baobuibk/SpaceLiinTech_HighVoltage_Electroporator_HW_V3.0.0_Controller/01_DESIGN/PCB1.PcbDoc.htm

Reporting Options

# File in Previous Format

Date | : | 3/28/2026
Time | : | 12:04:26 AM
Filename | : | D:\LAB209B3\SpaceLiinTech_Eletroporator\DuAn_HighVoltage_V3_270326\DuAn_HighVoltage_V3\PCB1.PcbDoc

Version | Warning
Release 24.4 | CAUTION - This PCB document contains polygon pours with the "Obey Rules" option enabled. If you save the PCB document in this older version, the "Obey Rules" option will be turned off for these polygon pours.

This file was generated by a later version of the software
