baobuibk/SpaceLiinTech_HighVoltage_Electroporator_HW_V3.0.0_Controller/03_BOM/DuAn_HighVoltage_V3.2.xlsx

HV_Elec_Controller_V3_HW |  |  |  |  |  |  | SMT
Line # | Name | Description | Designator | Footprint | Manufacturer | Part Num | Quantity | QtyTotal | QtySent | Note
 | 10uF/25V | CAP CER 10UF 25V X5R 0603 | C1A, C1B, C3A, C3B, C5A, C5B, C7A, C7B, C25, C28, C32, C34, C50, C51, C53, C56, C58, C62, C64, C112, C114, C116, C121 | CN-SMD-0603 | Samsung Electro-Mechanics | CL10A106MA8NRNC | 23
 | 100nF/25V | CAP CER 0.1UF 25V X7R 0603 | C2A, C2B, C4A, C4B, C6A, C6B, C8A, C8B, C26, C29, C30, C33, C35, C37, C52, C54, C57, C59, C63, C65, C66A, C66B, C67, C68, C69, C70, C71, C72, C73, C74A, C74B, C75A, C75B, C76, C77, C78, C81, C82, C83, C84, C85, C86, C87, C88, C89, C90, C105, C106, C107, C108, C109, C110, C111, C113, C115, C117, C118, C120, C122, C123, C124, C125, C126, C127, C128, C129, C130, C133, C134, C140, C141, C144, C145 | CN-SMD-0603 | Samsung Electro-Mechanics | CL10B104KA8NNNC | 73
 | 33pF/16V | CAP CER 33PF 16V X7R 0603 | C9A, C9B, C11A, C11B, C12A, C12B | CN-SMD-0603 | KEMET | C0603C330K4RACTU | 6
 | 0.022uF/200V | CAP CER 0.022UF 200V NP0 1206 | C10A | CN-SMD-1206 | KEMET | C1206C223J2GACAUTO | 1
 | 0.039uF/250V | CAP CER 0.039UF 250V X7R 1206 | C10B | CN-SMD-1206 | KEMET | C1206C393JARACTU | 1
 | 1000uF/400V | CAP ALUM 1000UF 20% 400V SNAP TH | C13, C14, C15, C16, C17, C18, C19, C20, C21, C22 | CA-ALU-35x50 | TDK | B43305A9108M000 | 10 |  |  | Không thấy PN trong BOM cũ
 | 10000uF/63V | CAP ALUM 15000UF 20% 63V SNAP TH | C23, C24 | CA-ALU-35x50 | Cornell Dubilier Knowles | 159LBB063M2EH | 2 |  |  | Không thấy PN trong BOM cũ
 | 10nF/25V | CAP CER 10000PF 25V X7R 0603 | C27, C31, C55 | CN-SMD-0603 | Samsung Electro-Mechanics | CL10B103KB8NNNC | 3
 | 100uF/20V | CAP TANT 100UF 10% 20V 2917 | C36, C40, C41, C42, C43, C44, C45, C46, C47, C48, C49, C60, C131, C142, C143 | Tantalum 2917 | KYOCERA AVX | TAJD107K020RNJ | 15
 | 470uF/10V | CAP TANT 470UF 10% 10V 2917 | C61, C132 | Tantalum 2917 | KYOCERA AVX | TAJE477K010RNJ | 2
 | 12pF | CAP CER 12PF 50V C0G/NP0 0603 | C79, C80 | CN-SMD-0603 | Samsung Electro-Mechanics | CL10C120JB81PNC | 2
 | 4.7nF/16V | 4700 pF ±10% 16V Ceramic Capacitor X7R 0603 (1608 Metric) | C119 | CN-SMD-0603 | KEMET | C0603C472K4RECAUTO | 1
 | 600V/5A | DIODE STANDARD 600V 5A DO214AB | D1A, D1B, D2A, D2B | DIO-SMD-C | Vishay General Semiconductor - Diodes Division | VS-5ECU06-M3/9AT | 4
 | 1N5819W | DIODE SCHOTTKY 40V 1A SOD123FL | D3A, D3B, D5A, D5B | DIO-SMD-123 | SMC Diode Solutions | 1N5819W | 4
 | SK34A | DIODE SCHOTTKY 40V 3A DO214AC | D4, D8 | DIO-SMD-A | SMC Diode Solutions | SK34A | 2
 | 1N4148 | DIODE STANDARD 100V 150MA SOD323 | D7, D9, D10 | DIO-SMD-323 | MCC (Micro Commercial Components) | 1N4148WX-TP | 3
 | DDZ9699T | DIODE ZENER 12V 150MW SOD523 | DZ1 | DIO-SMD-523 | Diodes Incorporated | DDZ9699T-7 | 1
 | ROCKET SW | CONN HEADER R/A 2POS 3.96MM | J1 | S2P-VH(LF)(SN) | JST Sales America Inc. | S2P-VH | 1
 | Header2 | Connector 2 | J2, J3A, J3B | XH2.54-2-DIP |  |  | 3
 | Header4 | Connector 4 | J4, J8, J12, J13, J14, J16 | XH2.54-4-DIP |  |  | 6
 | SM04B-SRSS-TBLFSN | CONN HEADER SMD R/A 4POS 1MM | J5 | BM04B-SRSS-TB | JST Sales America Inc. | SM04B-SRSS-TB | 1
 | Header3 | Connector 3 | J9 | XH2.54-3-DIP |  |  | 1
 | CHAR | CONN HEADER R/A 2POS 3.96MM | J10 | S2P-VH(LF)(SN) | JST Sales America Inc. | S2P-VH | 1
 | BAT | CONN HEADER R/A 2POS 3.96MM | J11 | S2P-VH(LF)(SN) | JST Sales America Inc. | S2P-VH | 1
 | JP3x2 | CONN RCPT 6POS 0.1 GOLD PCB | JP1, JP2, JP3, JP4, JP5, JP8 | JP3-C2T | TE Connectivity AMP Connectors | 5-534206-3 | 6
 | JP5x2 | CONN RCPT 10POS 0.1 GOLD PCB | JP6 | JP5-C2T | TE Connectivity AMP Connectors | 5-534206-5 | 1
 | 22 μH | FIXED IND 22UH 2.5A 170 MOHM SMD, P/N: SRP7050TA-220M | L1, L2 | PSM6050 | Bourns Inc. | SRP7050TA-220M | 2
 | 8.2 μH | FIXED IND 8.2UH 8A 24 MOHM SMD | L5 | PSM1040 | Bourns Inc. | SRP1038A-8R2M | 1
 | LED | LED RED CLEAR 0603 SMD | LED1, LED2, LED3 | LED-0603-RED | Wurth Elektronik | 150060RS75000 | 3
 | IPD082N10N3 G | MOSFET N-CH 100V 80A DPAK | Q1A, Q1B, Q3, Q4 | TO252-123 | UMW | IPD082N10N3G | 4
 | IPD60R600CM8XTMA1 | MOSFET N-CH 600 V 7A (Tj) 64W (Tc) Surface Mount PG-TO252-3-313 | Q2A, Q2B | TO252-123 | Infineon Technologies | IPD60R600CM8XTMA1 | 2
 | AO3400 | MOSFET N-CH 30V 5.7A SOT23-3L | Q5A, Q5B, Q17 | SOT23-123 | Alpha & Omega Semiconductor Inc. | AO3400 | 3
 | MMBT2222A | TRANS NPN 40V 0.6A SOT-23 | Q6A, Q6B | SOT23-132 | Nexperia USA Inc. | MMBT2222A,215 | 2
 | AONS21303C | MOSFET P-CH 30V 180A 8DFN | Q12, Q13 | PowerPAK SO-8 Single | Alpha & Omega Semiconductor Inc. | AONS21303C | 2
 | AON7418 | MOSFET N-CH 30V 46A/50A 8DFN | Q14, Q15 | DFN3.3x3.3_8L | Alpha & Omega Semiconductor Inc. | AON7418 | 2
 | AO3401 | P-MOS 30V 4A | Q16 | SOT23-123 | Alpha & Omega Semiconductor Inc. | AO3401 | 1
 | 1k/1% | RES SMD 1K OHM 1% 1/10W 0603 | R1A, R1B, R17, R18, R31, R35A, R35B, R59 | RES-SMD-0603 | Panasonic Electronic Components | ERJ-3EKF1001V | 8
 | 3.6K/1% | RES 3.6K OHM 1% 1W 1206 | R2A | RES-SMD-1206 | Vishay Dale | RCS12063K60FKEA | 1
 | 2.1K/1% | RES 2.1K OHM 1% 2W 1206 | R2B | RES-SMD-1206 | TE Connectivity Passive Product | 3503G2B2K1FTD | 1
 | 51R/1% | RES SMD 51 OHM 1% 1/10W 0603 | R3A, R3B, R5A, R5B | RES-SMD-0603 | Panasonic Electronic Components | ERJ-3EKF51R0V | 4
 | 11R/1% | RES SMD 11 OHM 1% 3/4W 1206 | R4A, R4B, R6A, R6B | RES-SMD-1206 | Vishay Dale | CRCW120611R0FKEAHP | 4
 | 5.1k/1% | RES SMD 5.1K OHM 1% 1/10W 0603 | R7A, R7B, R9A, R9B, R62, R67, R97A, R97B, R173, R174, R175, R176, R182 | RES-SMD-0603 | Panasonic Electronic Components | ERJ-3EKF5101V | 13
 | 470R/1% | RES 470 OHM 1% 1/10W 0603 | R8A, R8B, R26A, R26B, R27A, R27B, R53, R57, R60, R65 | RES-SMD-0603 | YAGEO | RC0603FR-07470RL | 10
 | 220k/1%/0.5W | RES SMD 220K OHM 1% 1/2W 2010 | R10, R11, R12, R13, R14, R15 | RES-SMD-2010 | Bourns Inc. | CHV2010-FX-2203ELF | 6
 | 10k/1% | RES SMD 10K OHM 1% 1/10W 0603 | R16, R19, R21, R23, R24, R28A, R28B, R36, R37, R38, R39, R40, R41, R46, R47, R52, R56, R63, R68, R69, R79, R80, R81, R82, R86, R87, R88, R89, R94, R95, R96, R98, R106, R170, R172, R185, R195, R196, R197, R198, R199, R206 | RES-SMD-0603 | Panasonic Electronic Components | ERJ-3EKF1002V | 42
 | 47K/1% | RES SMD 47K OHM 1% 1/10W 0603 | R20, R22 | RES-SMD-0603 | Panasonic Electronic Components | ERJ-3EKF4702V | 2
 | 3.24K/1% | RES SMD 3.24K OHM 1% 1/10W 0603 | R25, R70 | RES-SMD-0603 | Panasonic Electronic Components | ERJ-3EKF3241V | 2
 | 22R/1% | RES SMD 22 OHM 1% 1/10W 0603 | R29, R32, R33, R34, R42, R43, R44, R45, R48, R49, R84, R85, R90, R91, R92, R93, R99, R100, R101, R102, R103, R104, R169, R171, R177, R178, R179, R180, R200, R201, R202, R203, R204, R205 | RES-SMD-0603 | Panasonic Electronic Components | ERJ-3EKF22R0V | 34
 | 25mR/1%/1.5W | RESISTOR - ISA-PLAN SHUNT, 0.025 | R30, R181, R186 | RES-SMD-1206 | Isabellenhuette USA | VMK-R025-1.0-U | 3
 | 100k/0.5% | RES SMD 100K OHM 5% 1/2W 2010 | R50, R51 | RES-SMD-2010 | Bourns Inc. | CHV2010-JW-104ELF | 2
 | 2k/1% | RES SMD 2K OHM 1% 1/10W 0603 | R54 | RES-SMD-0603 | Panasonic Electronic Components | ERJ-3EKF2001V | 1
 | 51k/1% | RES 51K OHM 1% 1/10W 0603 | R55 | RES-SMD-0603 | YAGEO | RC0603FR-0751KL | 1
 | 3.3k/1% | RES SMD 3K3 OHM 0.1% 1/10W 0603 | R58 | RES-SMD-0603 | Panasonic Electronic Components | ERJ-3EKF3301V | 1
 | 4.7k/1% | RES SMD 4.7K OHM 1% 1/10W 0603 | R61, R66 | RES-SMD-0603 | Panasonic Electronic Components | ERJ-3EKF4701V | 2
 | 953R/1% | RES SMD 953 OHM 1% 1/10W 0603 | R64 | RES-SMD-0603 | Panasonic Electronic Components | ERJ-3EKF9530V | 1
 | 50R/50W | TPAN0263F50R0K9 | R71, R72, R73, R74, R75, R76, R77, R78 | TO263-123 |  | TPAN0263F50R0K9 | 8
 | 3k/1% | RES SMD 3K OHM 0.1% 1/10W 0603 | R83, R189, R191 | RES-SMD-0603 | Panasonic Electronic Components | ERA-3AEB302V | 3
 | 110k/1% | RES 110K OHM 1% 1/10W 0603 | R183, R187, R190 | RES-SMD-0603 | YAGEO | RC0603FR-07110KL | 3
 | 6.04k/1% | RES 6.04K OHM 1% 1/10W 0603 | R188 | RES-SMD-0603 | YAGEO | RC0603FR-076K04L | 1
 | 26.7k/1% | RES 26.7K OHM 1% 1/10W 0603 | R194 | RES-SMD-0603 | Stackpole Electronics Inc | RMCF0603FT26K7 | 1
 | DA2034_AL | Audio Transformers / Signal Transformers DA2032 Cap Chrgr For Linear LT3750/51 | Tran1A, Tran1B | DA2034_AL |  | DA2034_ALD | 2
 | UCC21551BDWKR | 4A/6A 5KVRMS DUAL-CHANNEL ISOLAT | U1A, U1B | UCC21551BDWKR | Texas Instruments | UCC21551BDWKR | 2
 | LTC4359 | IC OR CTRLR N+1 8MSOP | U2 | VSSOP8 | Analog Devices Inc. | LTC4359CMS8#TRPBF | 1
 | TPS5430DDAR | IC REG BUCK ADJ 3A 8SOPWR | U3, U6 | HSOP8 | Texas Instruments | TPS5430DDAR | 2
 | MB85RS2MTAPNF-G-BDERE1 | IC FRAM 2MBIT SPI 40MHZ 8SOP | U4 | SOIC127P602X173-8N | RAMXEED | MB85RS2MTAPNF-G-BDERE1 | 1
 | TEL 5-1212 | DC DC CONVERTER 12V 6W | U5 | TEL_5-XXYY_SINGLE | Traco Power | TEL 5-1212 | 1
 | LM1117-3.3V | IC REG LIN 3.3V 800MA SOT-223-4 | U7 | SOT223 | Texas Instruments | TLV1117-33IDCYR | 1
 | OPTO | OPTOISO 3.75KV 1CH TRANS 4-SSOP | U8A, U8B | EL3H7 | Everlight Electronics Co Ltd | EL3H7(B)(TA)-VG | 2
 | ADUM1201 | DGTL ISOLTR 2.5KV 2CH GP 8-SOIC | U9, U25 | SO8 | Analog Devices Inc. | ADUM1201CRZ-RL7 | 2
 | MAX232DR | IC TRANSCEIVER FULL 2/2 16SOIC | U10 | SO16 | Texas Instruments | MAX232DR | 1
 | TC1047AVNBTR | SENSOR ANALOG -40C-125C SOT23-3 | U11A, U11B | SOT23-132 | Microchip Technology | TC1047AVNBTR | 2
 | H3LIS331DL | ACCEL 100-400G I2C/SPI 16TFLGA | U12 | TFLGA-16L | STMicroelectronics | H3LIS331DLTR | 1
 | STM32F405RGT7 | High-performance foundation line, ARM Cortex-M4 core with DSP and FPU, 1 Mbyte Flash, 168 MHz CPU, ART Accelerator | U13 | LQFP64 | STMicroelectronics | STM32F405RGT7 | 1
 | OPA340NA/250 | IC OPAMP GP 1 CIRCUIT SOT23-5 | U14, U15 | SOT23-5 | Texas Instruments | OPA340NA/250 | 2
 | TLV7031DCKT | IC COMPARATOR 1 GEN PUR SC70-5 | U16, U17 | SOT353 | 296-49506-6-ND | TLV7031DCKT | 2
 | XBEE S3B PRO |  | U20 | XBEE S3B PRO DIP |  |  | 1
 | ADUM1250 | DGTL ISOLTR 2.5KV 2CH I2C 8-SOIC | U21 | SO8 | Analog Devices Inc. | ADUM1250ARZ-RL7 | 1
 | LTC4012IUF#PBF | IC BAT CHG MULT-CHEM 1-4CL 20QFN | U22 | PQFN50P400X400X80_HS-21N | Analog Devices Inc. | LTC4012IUF#PBF | 1
 | ADS1115 | IC ADC 16BIT SIGMA-DELTA 10X2QFN | U23 | R-PQFP-N10 | Texas Instruments | ADS1115IRUGR | 1
 | LSM6DSOX | INEMO INERTIAL MODULE: 3D ACCELE | U26 | LSM6DSOX | STMicroelectronics | LSM6DSOXTR | 1
 | XTAL_8MHz | CRYSTAL 8.0000MHZ 8PF SMD | X1 | XT4-16.000MHz-4_V | ECS Inc. | ECS-80-8-33Q-ADS | 1
 |  | Connector, module cắm ngoài
 |  | Không có stock digi
