baobuibk/SpaceLiinTech_HighVoltage_Electroporator_HW_V3.0.0_Controller/02_Sche_PDF/DuAn_HVC_PDF.pdf

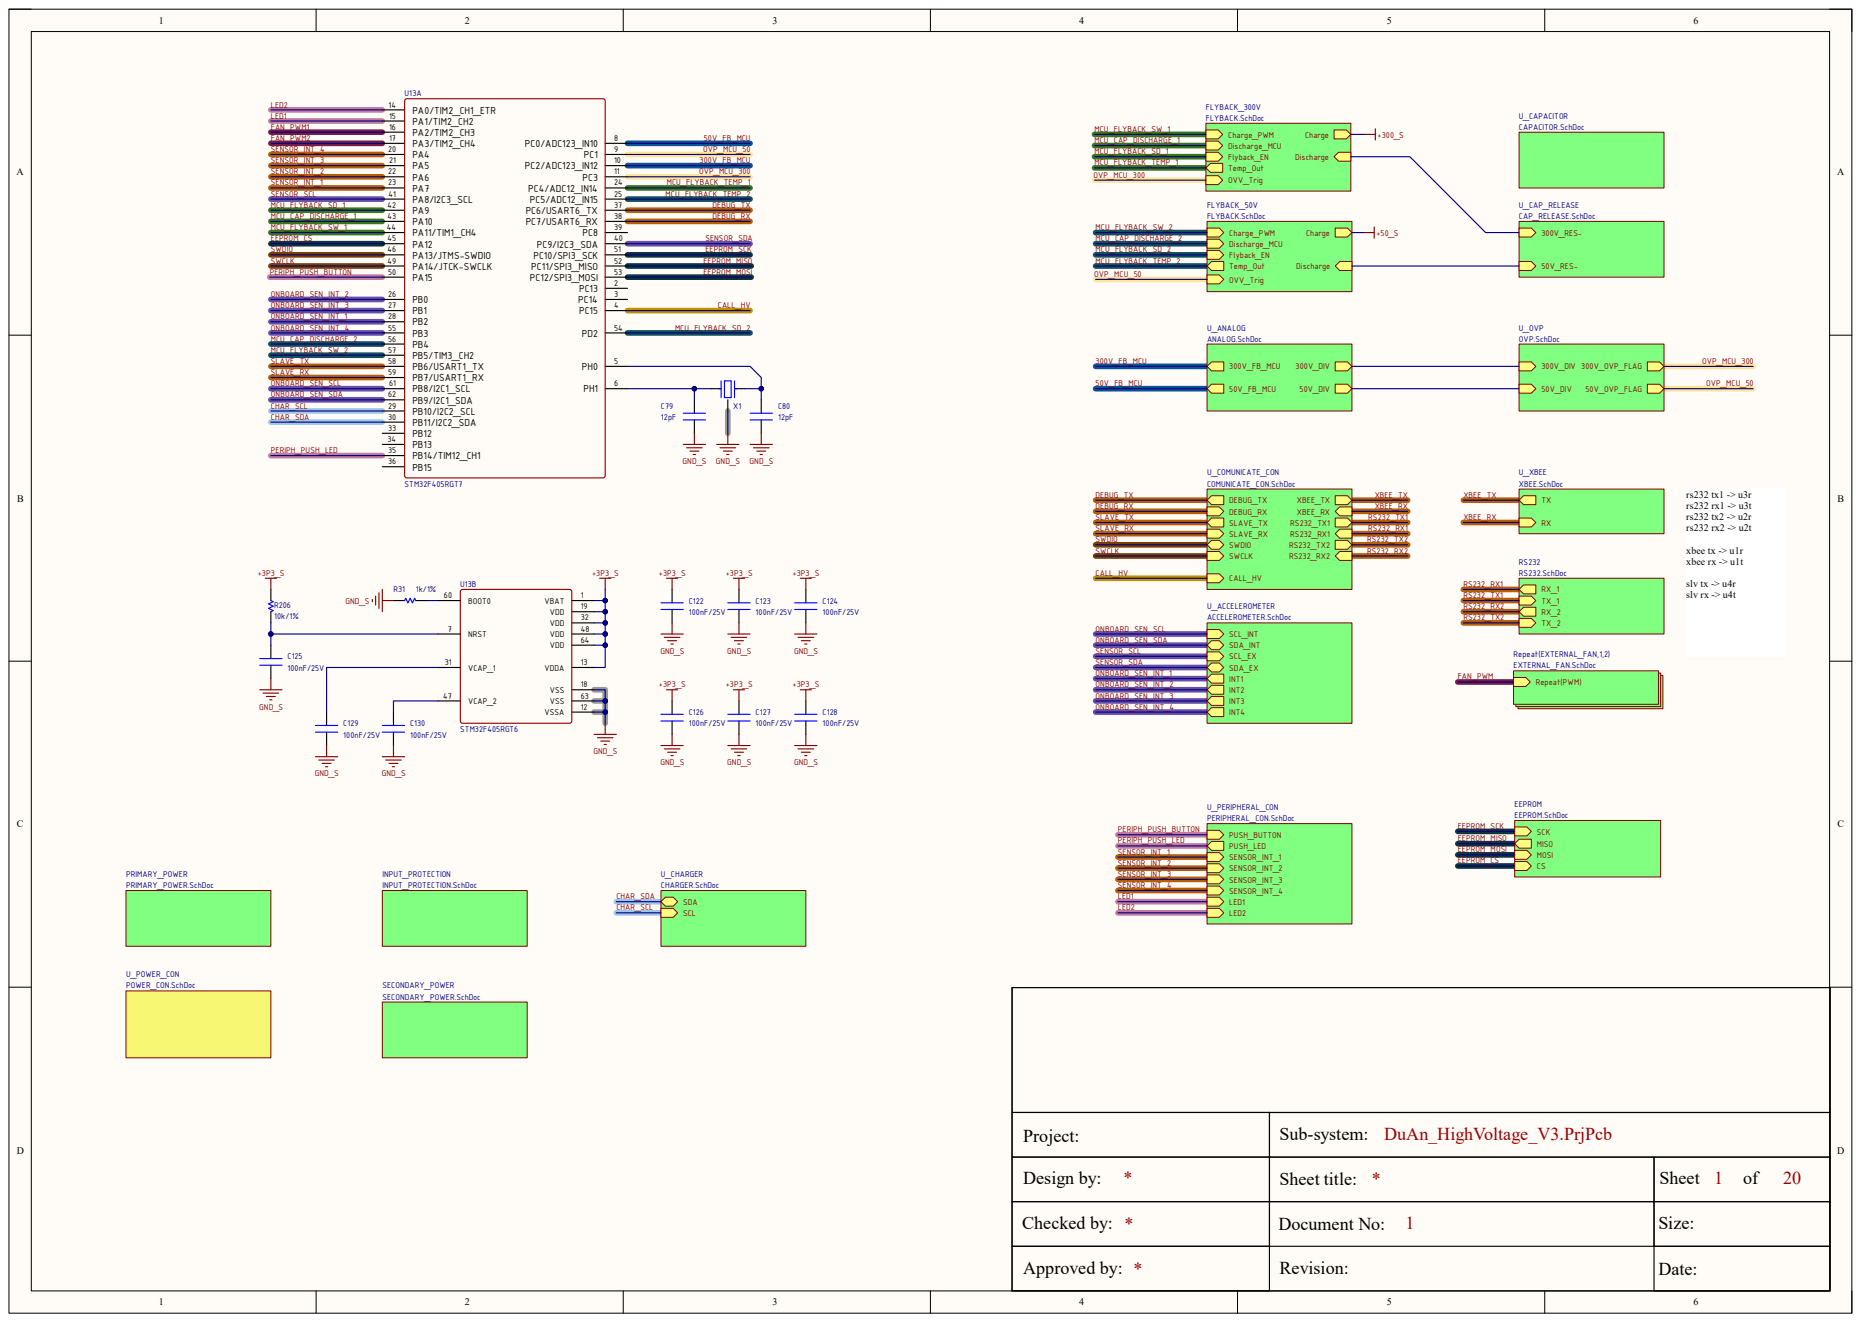
[picture p4: page 1]

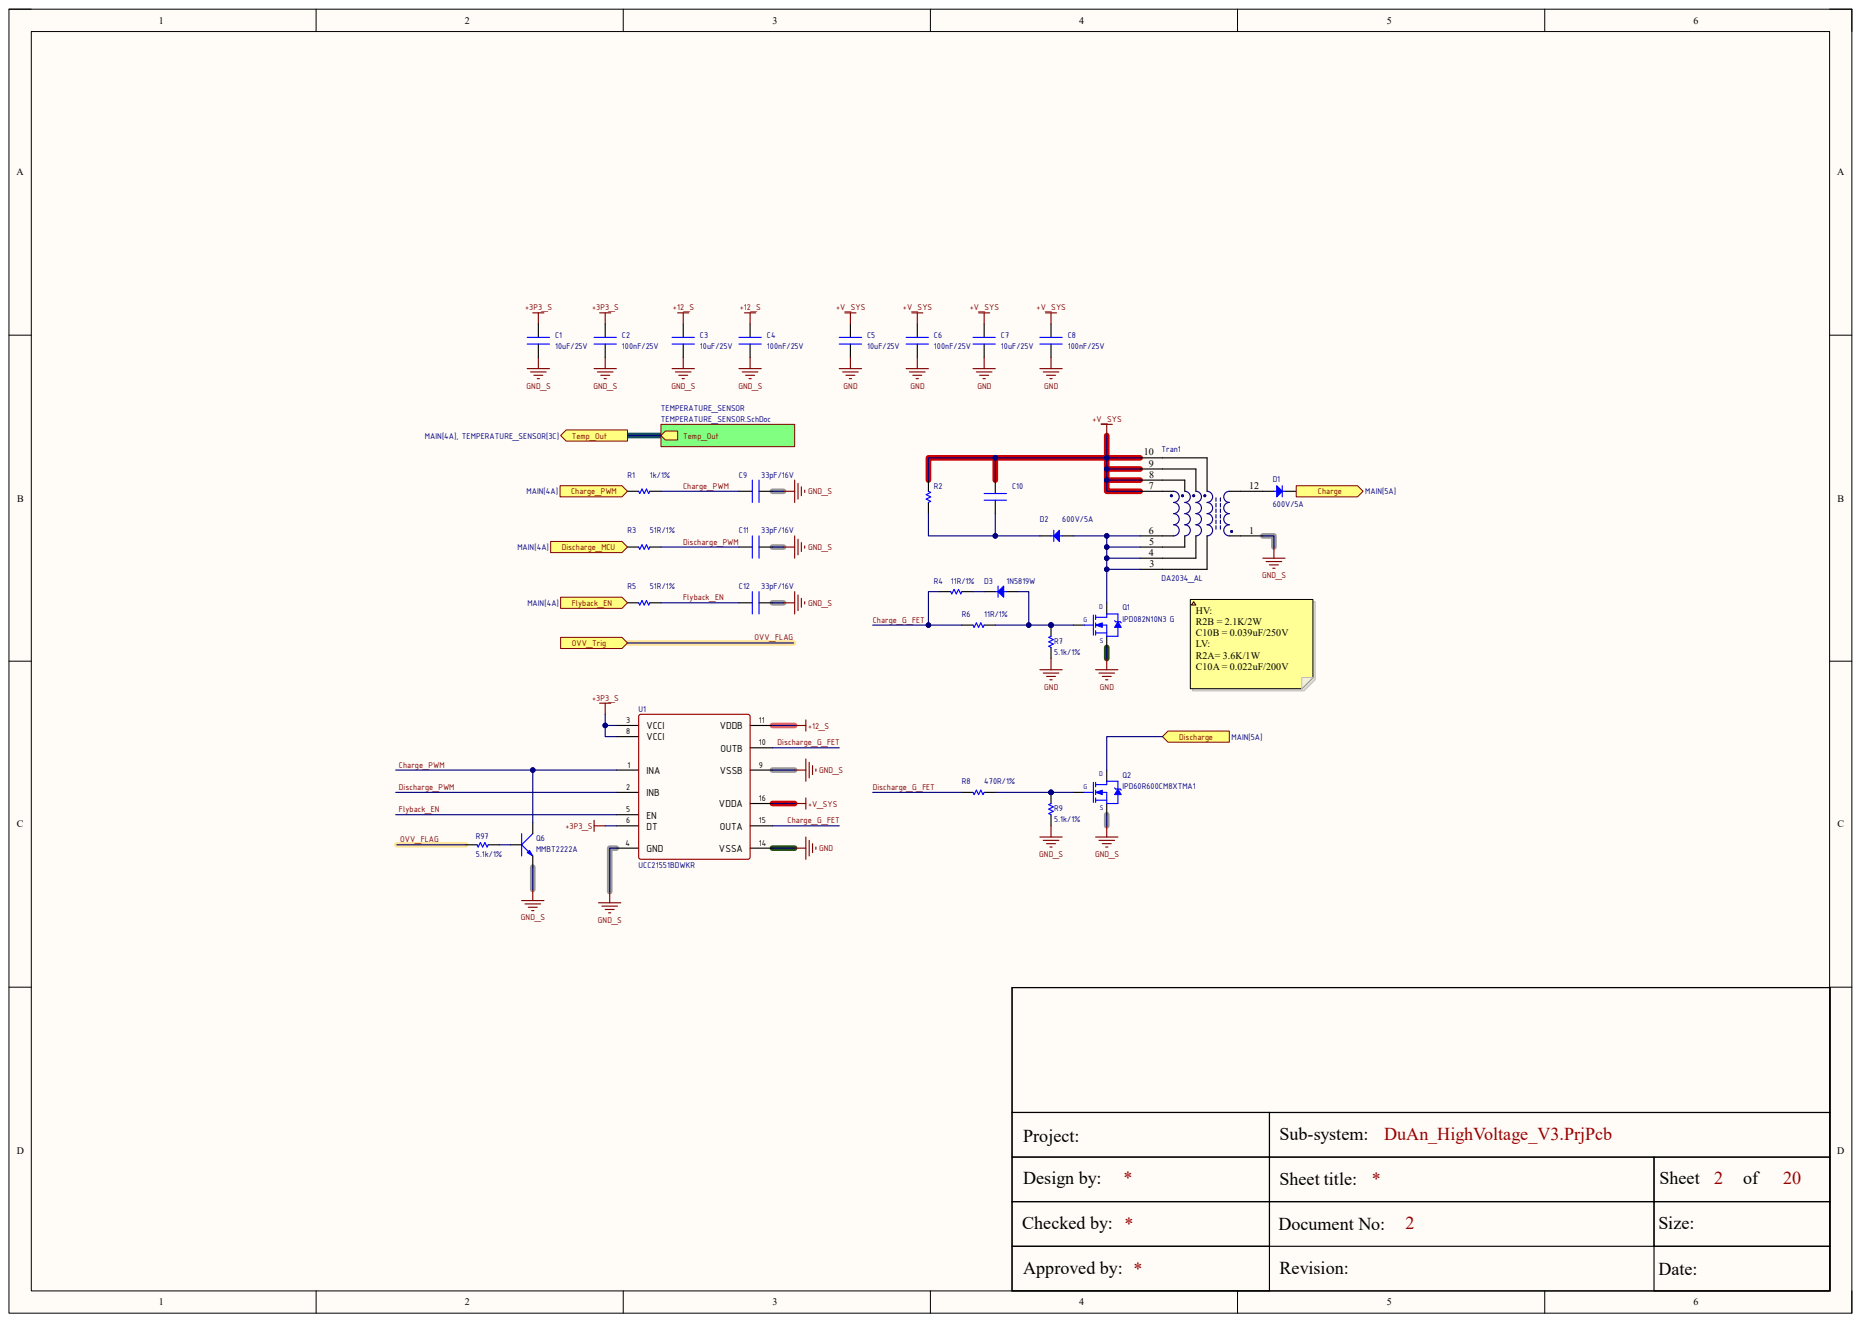
[picture p5: page 2]

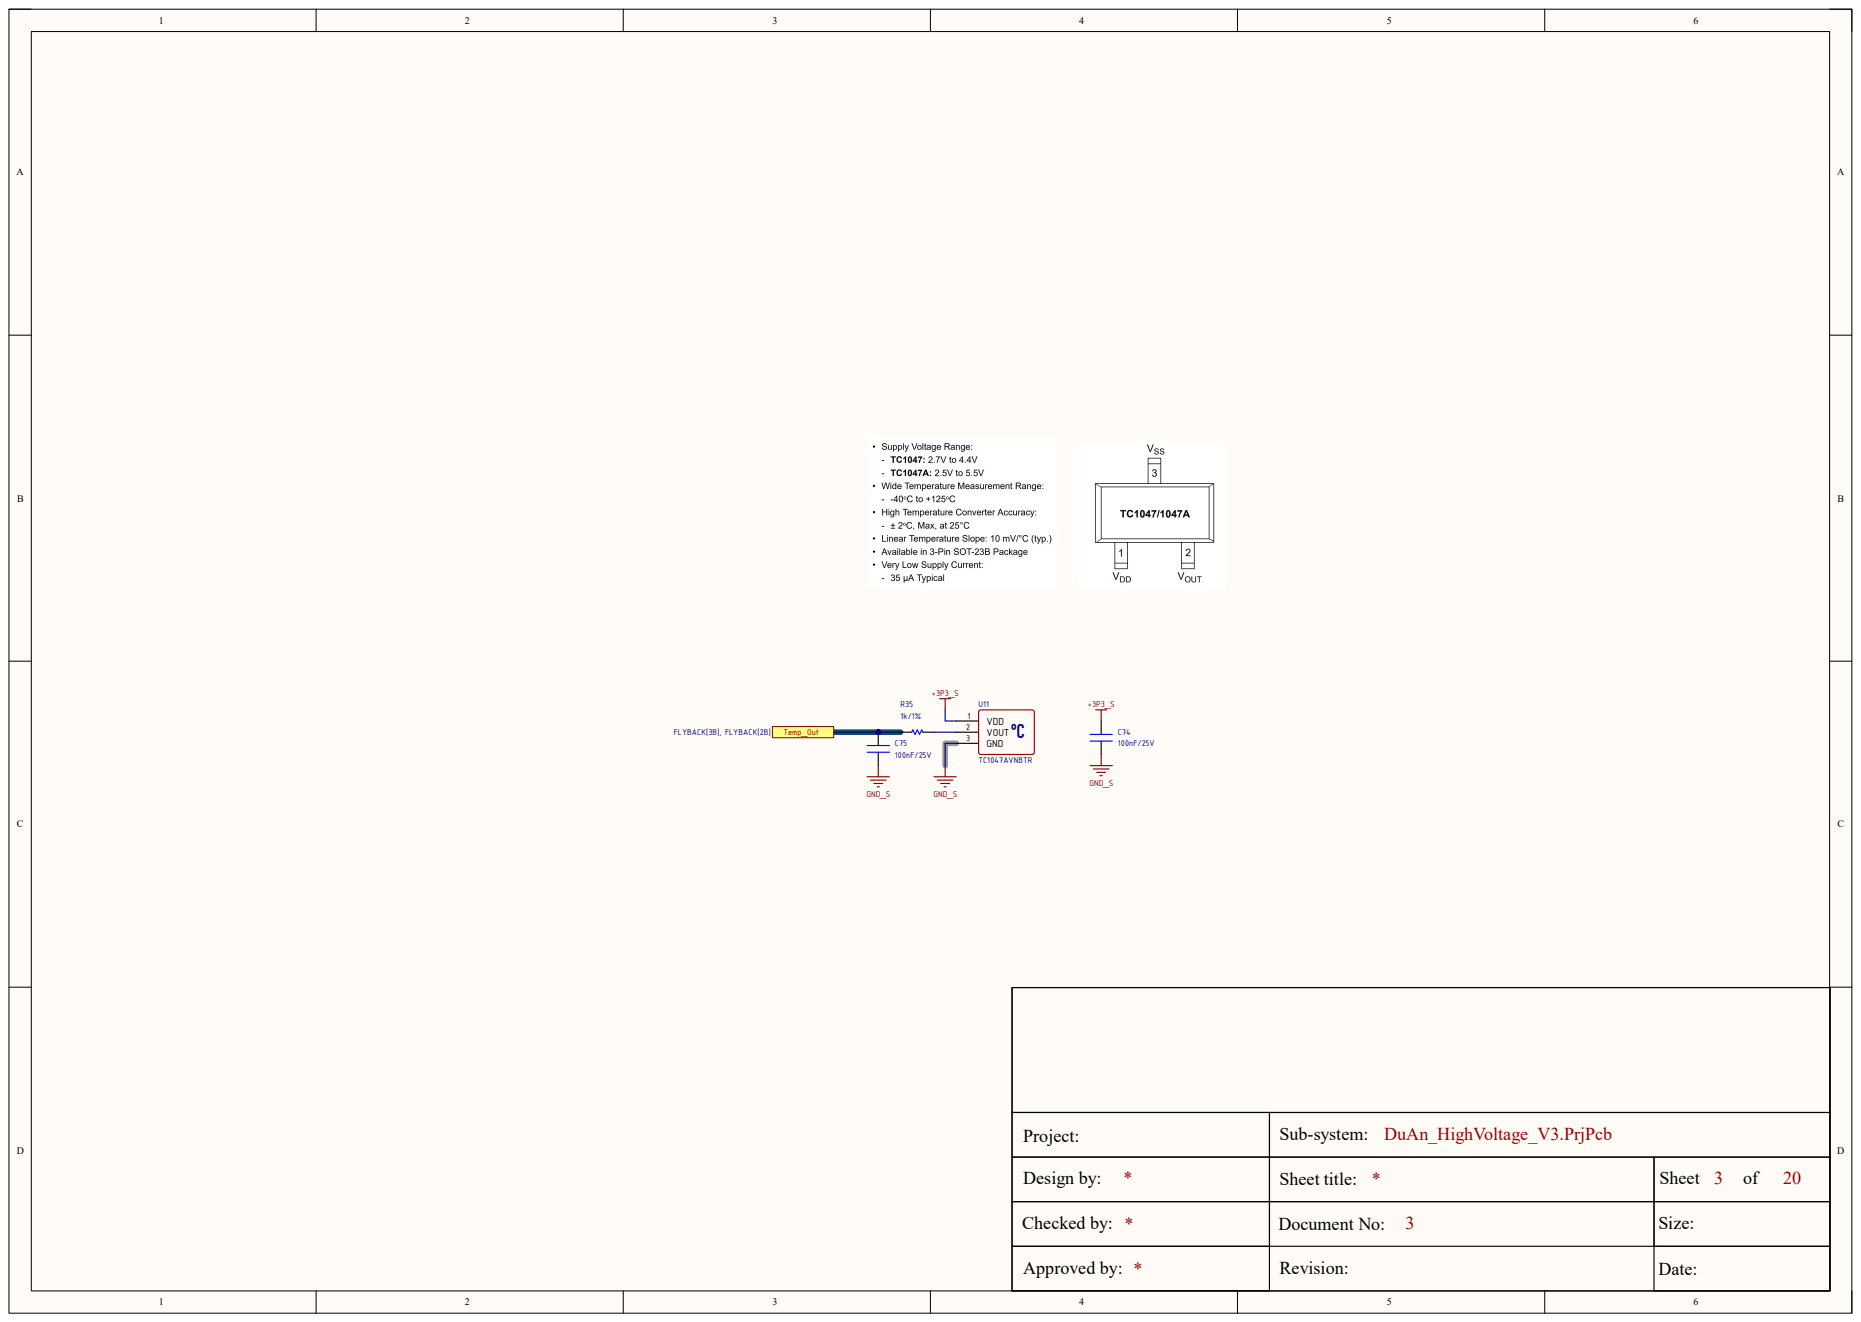
[picture p6: page 3]
Project:; Design by:; Sub-system:; Sheet title:; Sheet; DuAn_HighVoltage_V3.PrjPcb; VDD ¹ VOUT ²; GND ³; TC1047AVNBTR; GND_S; FLYBACK[3B], FLYBACK[2B] Temp_Out

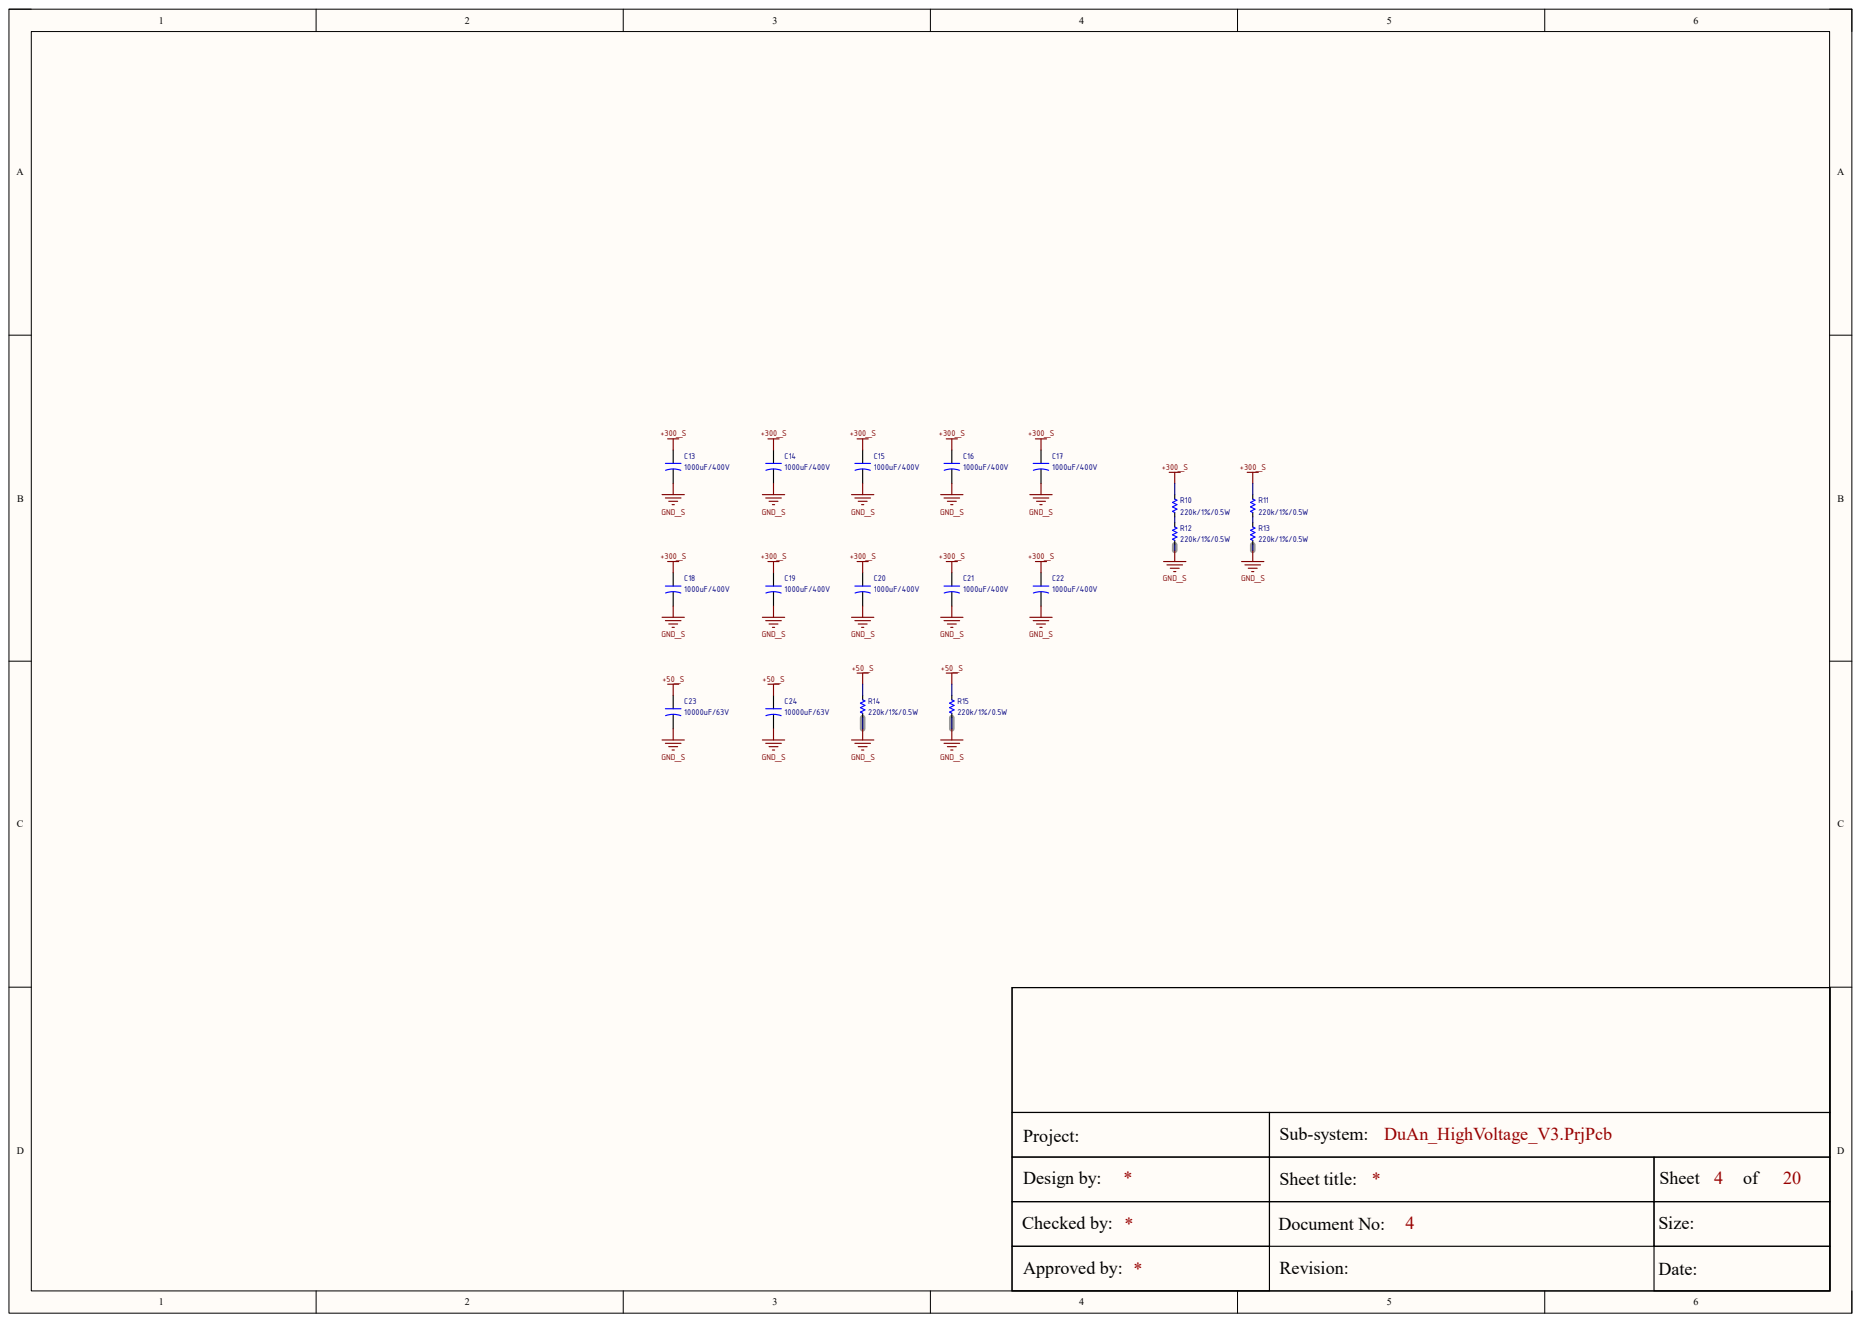
[picture p7: page 4]

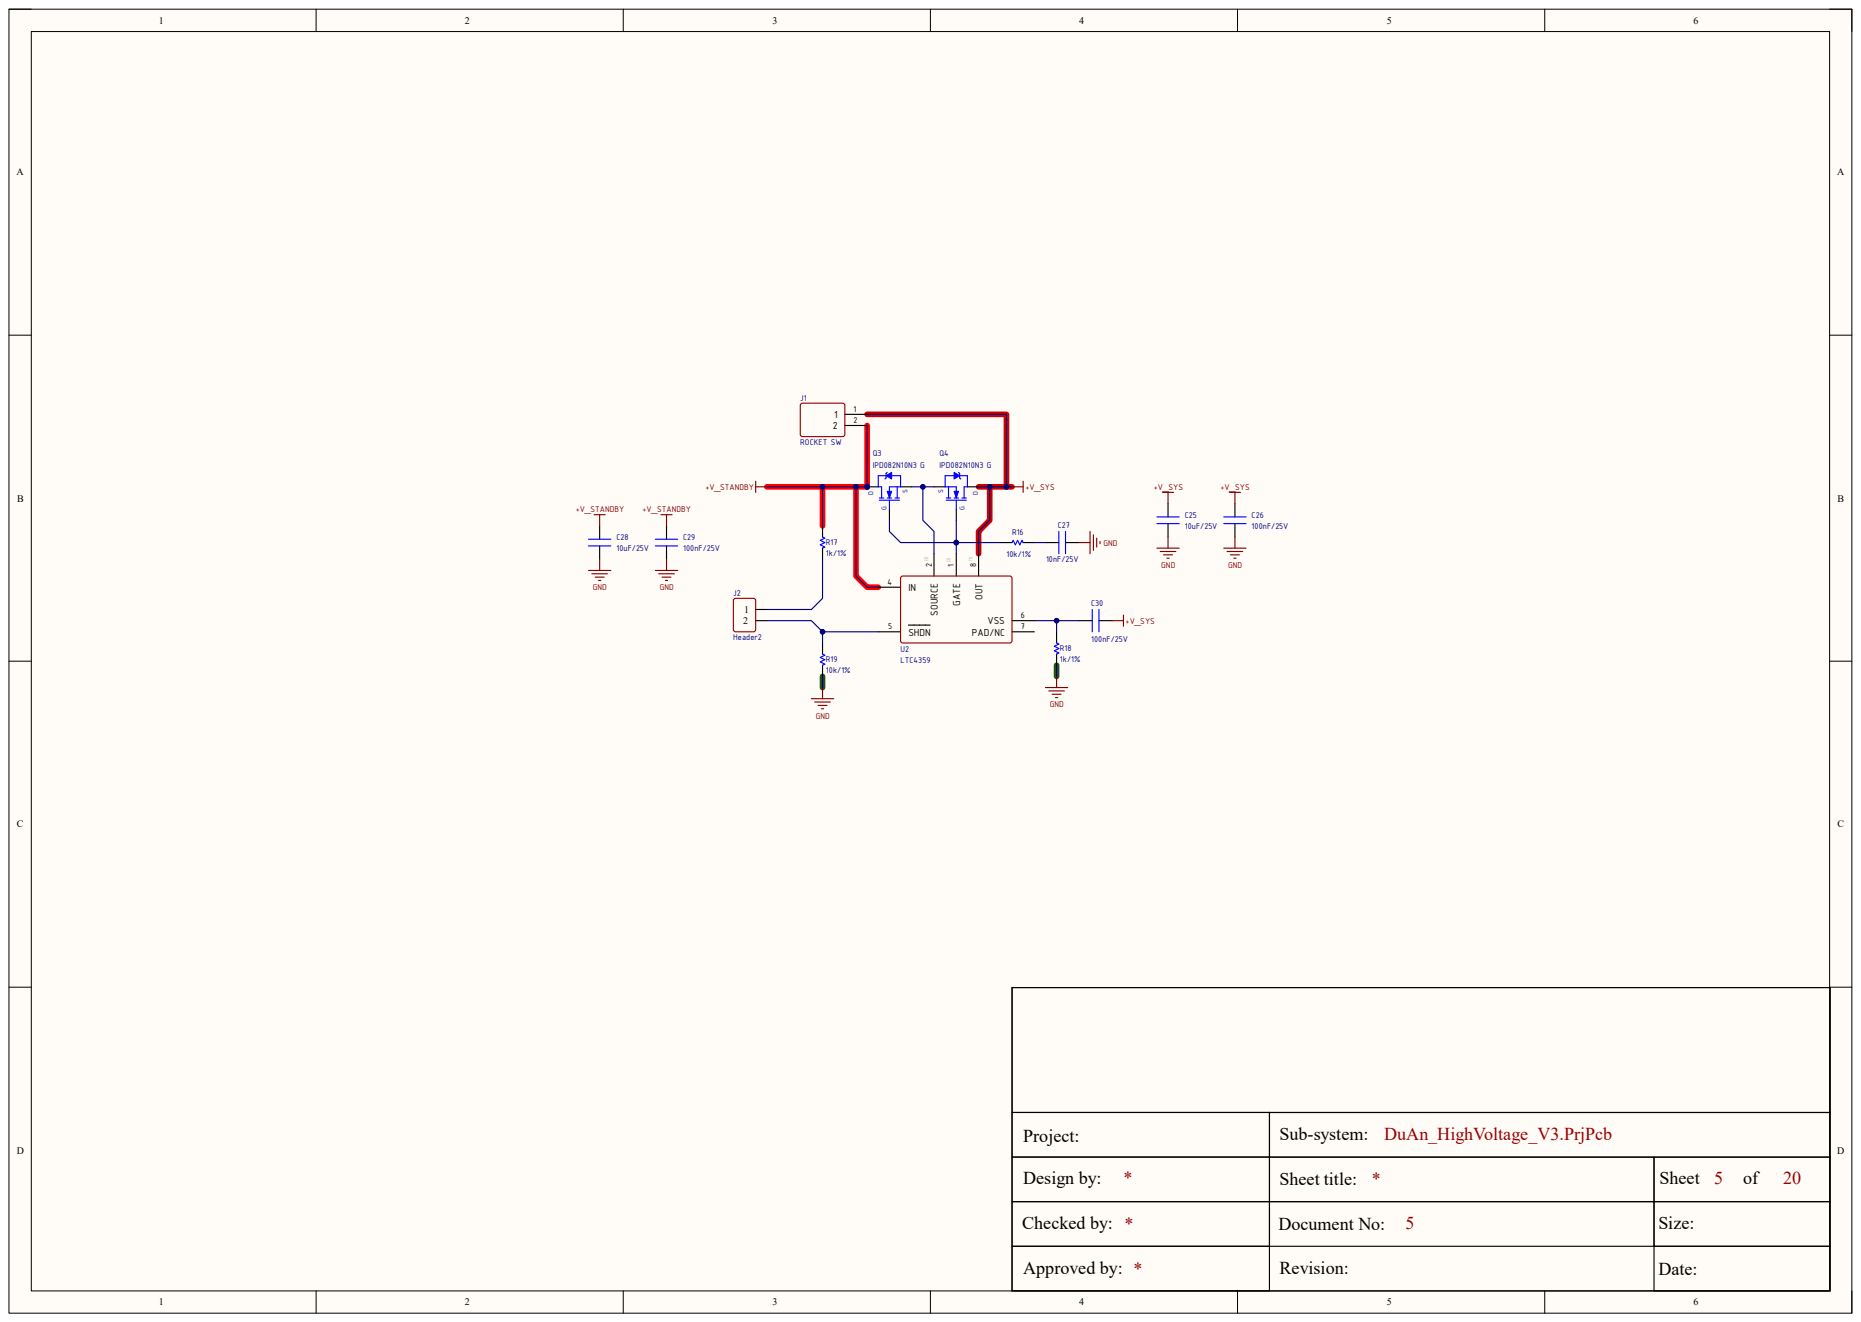
[picture p8: page 5]

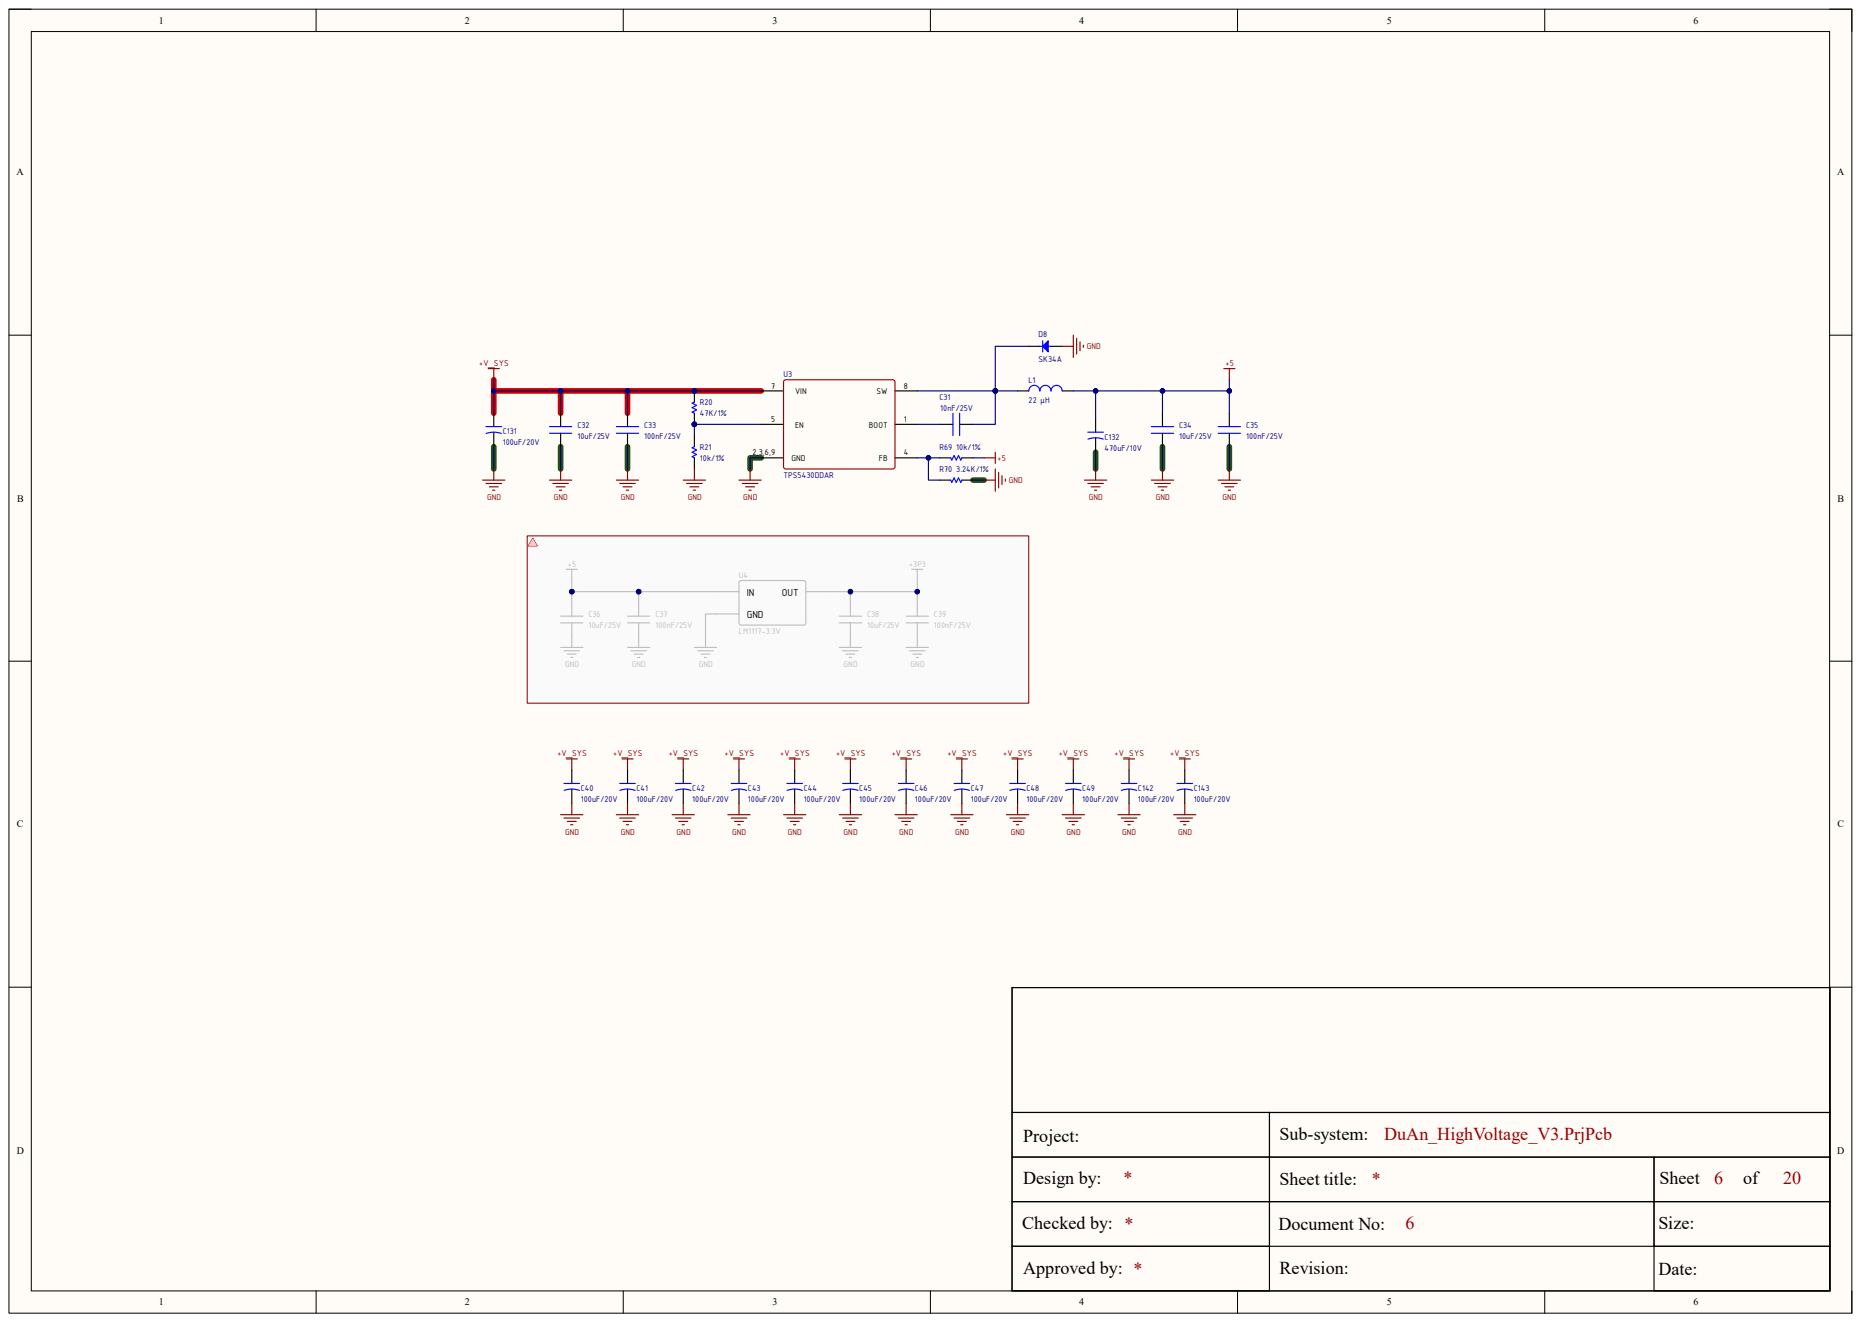
[picture p9: page 6]

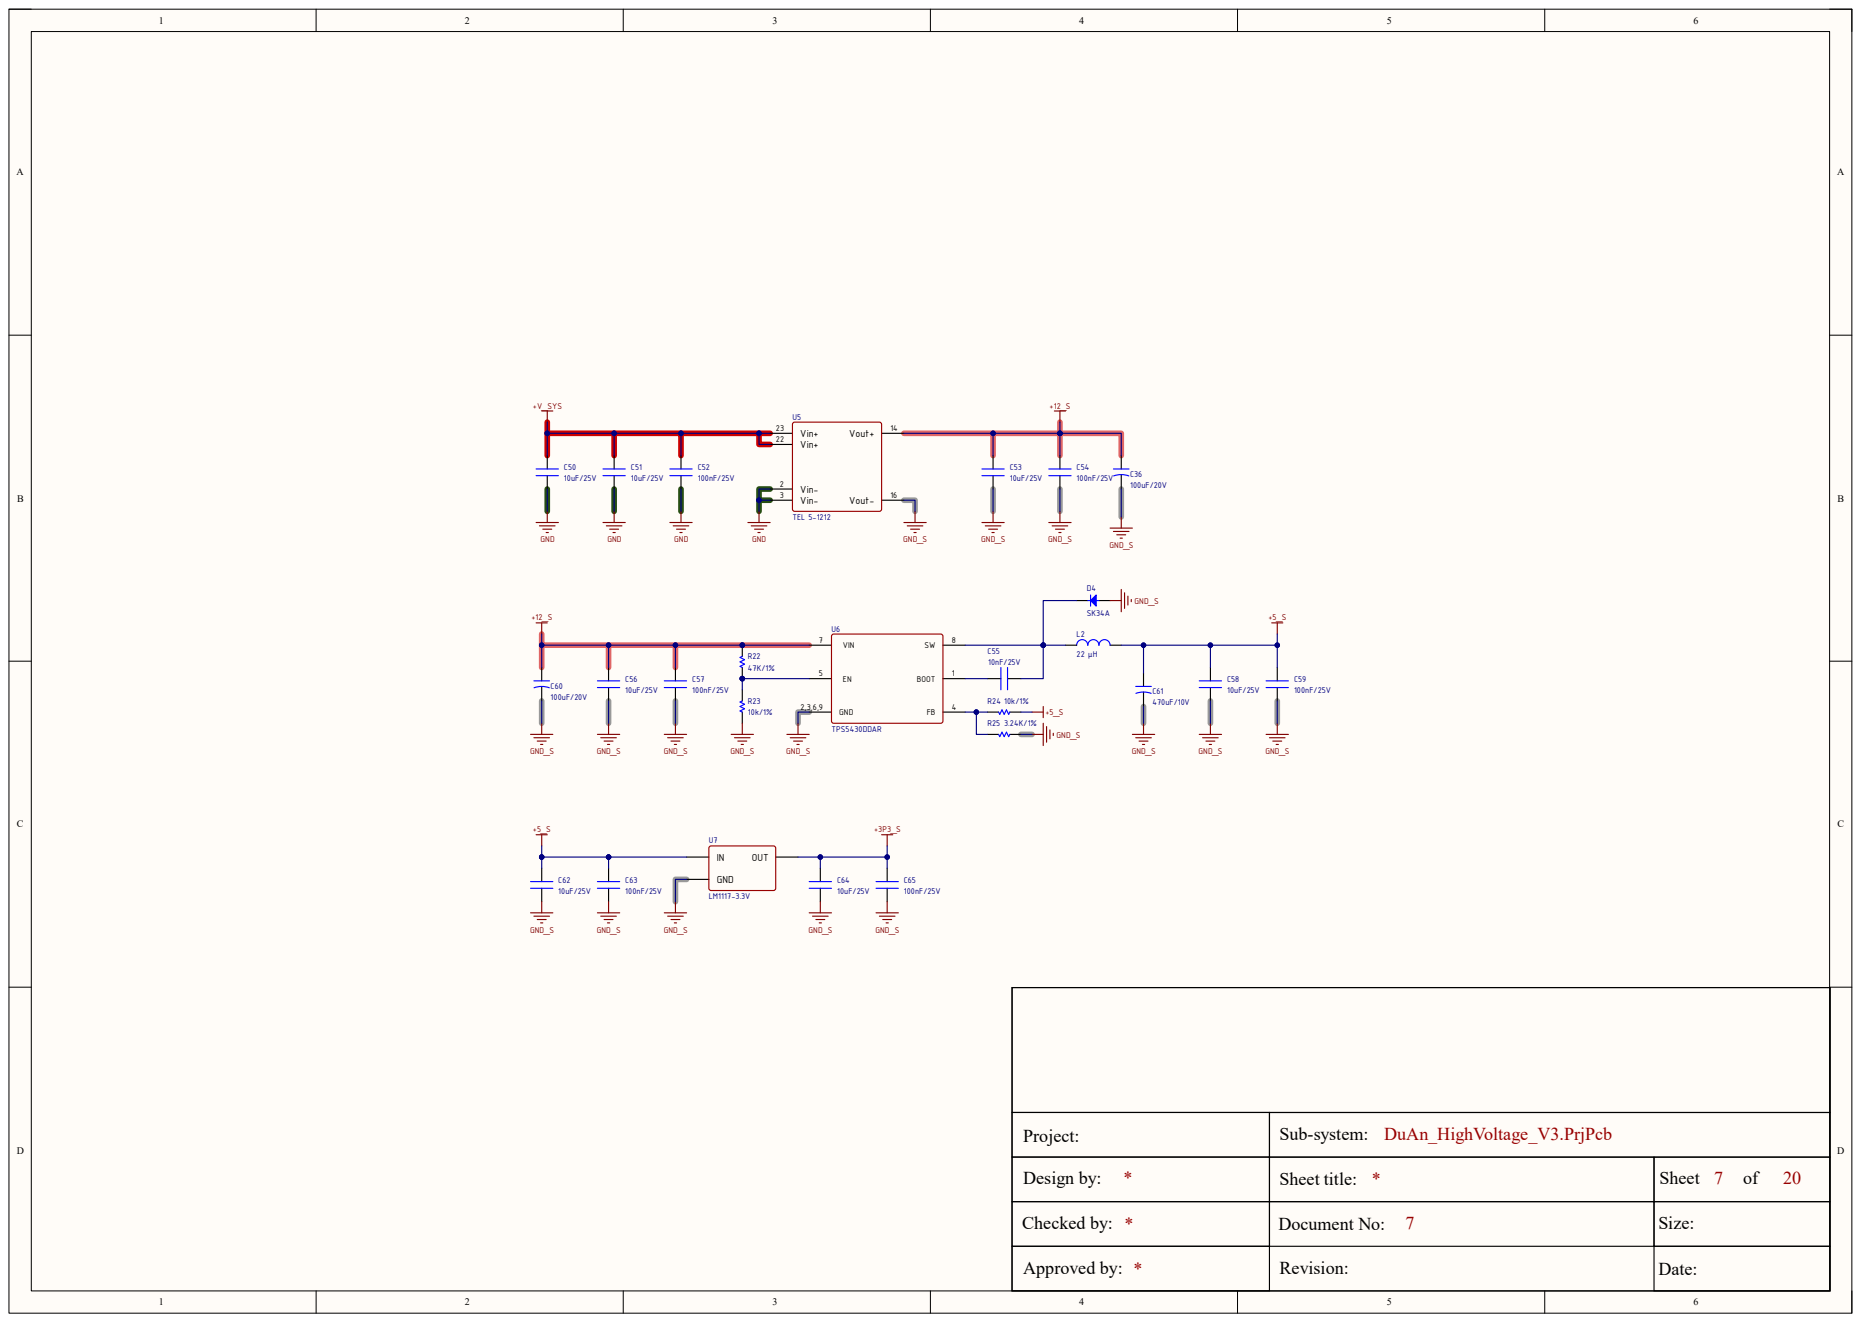
[picture p10: page 7]

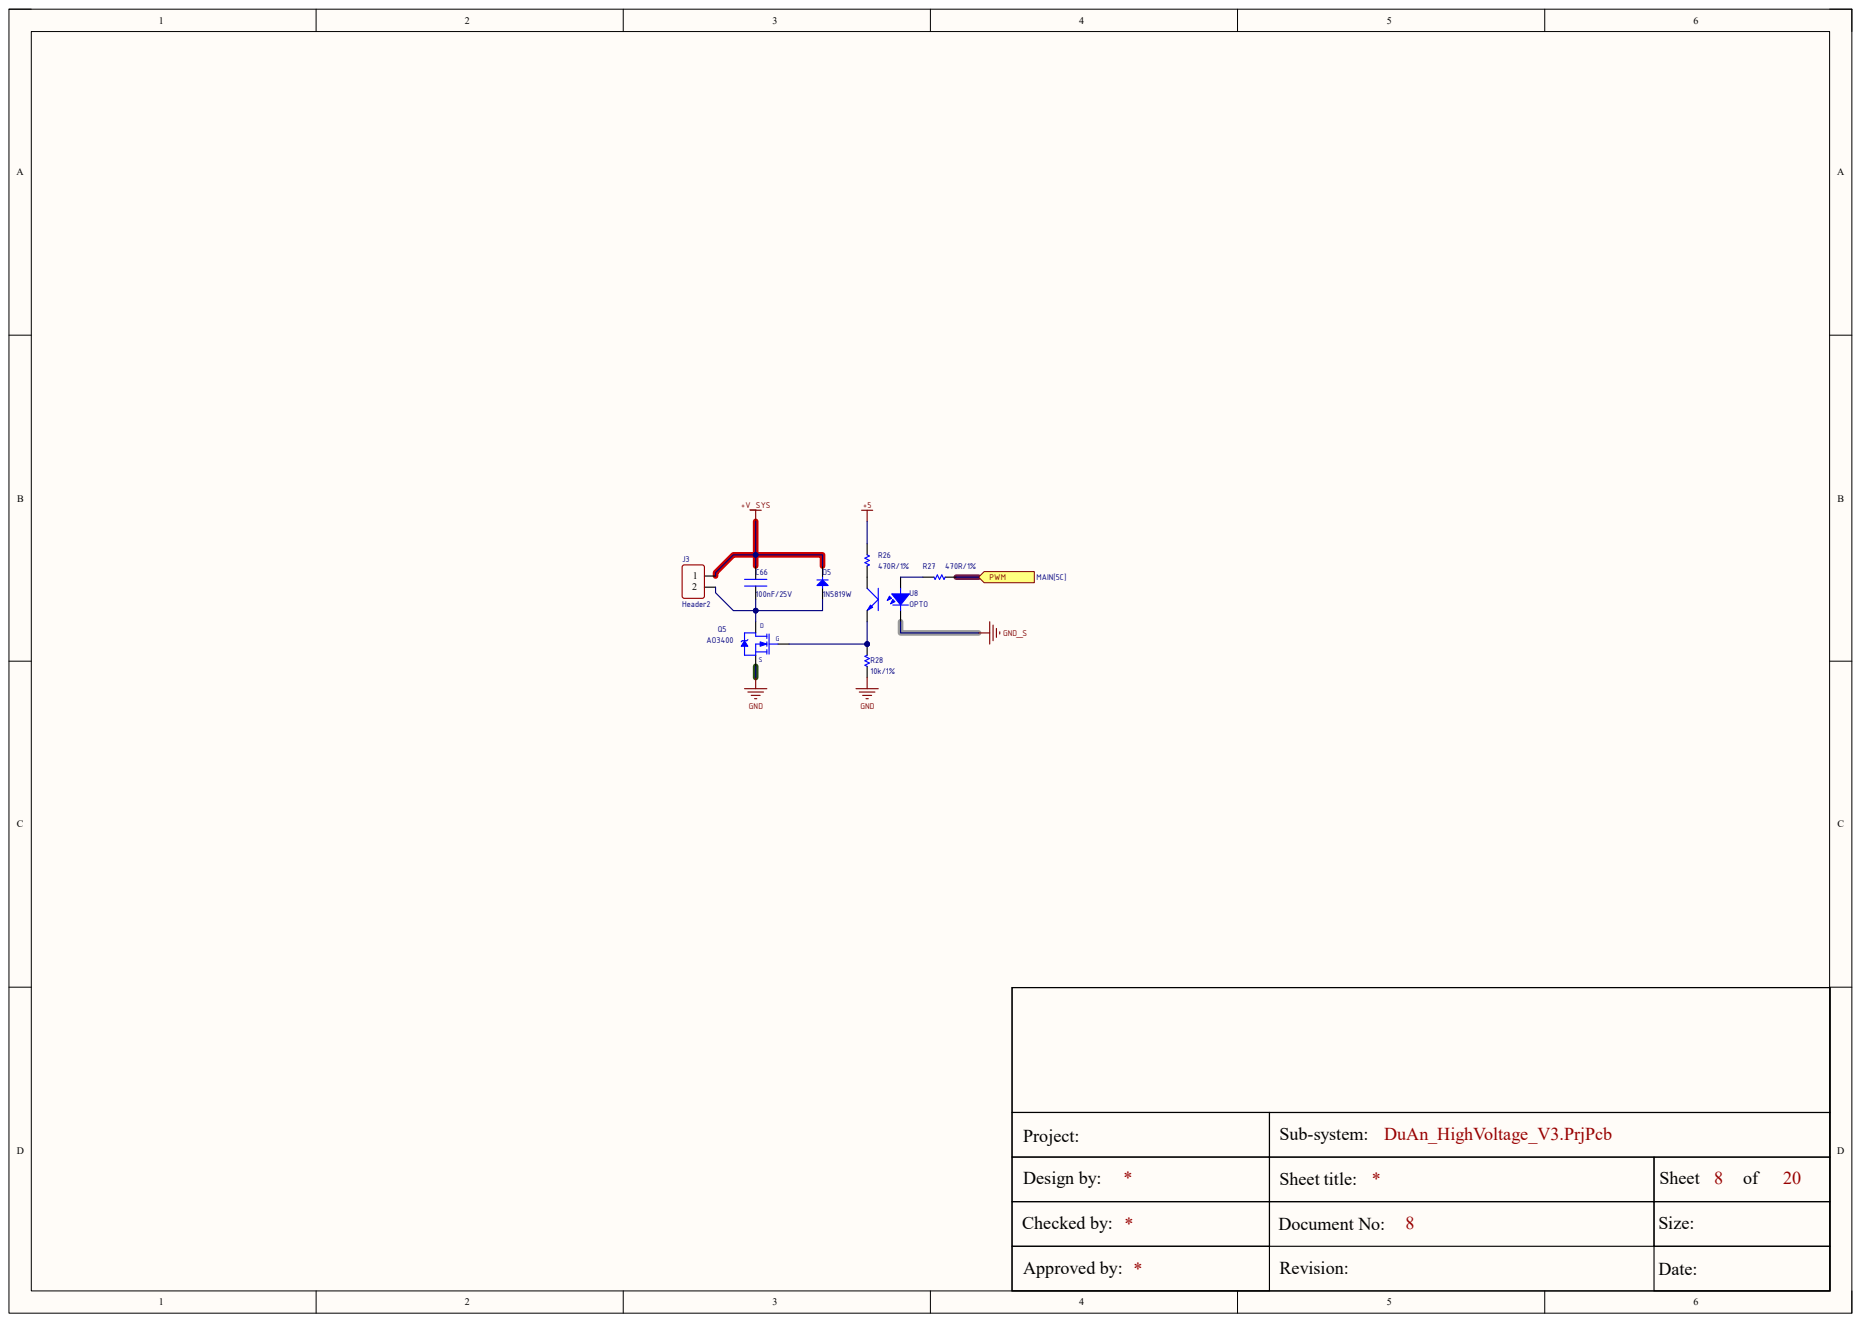
[picture p11: page 8]

## VDD.1 ¹

## VDD.2 8

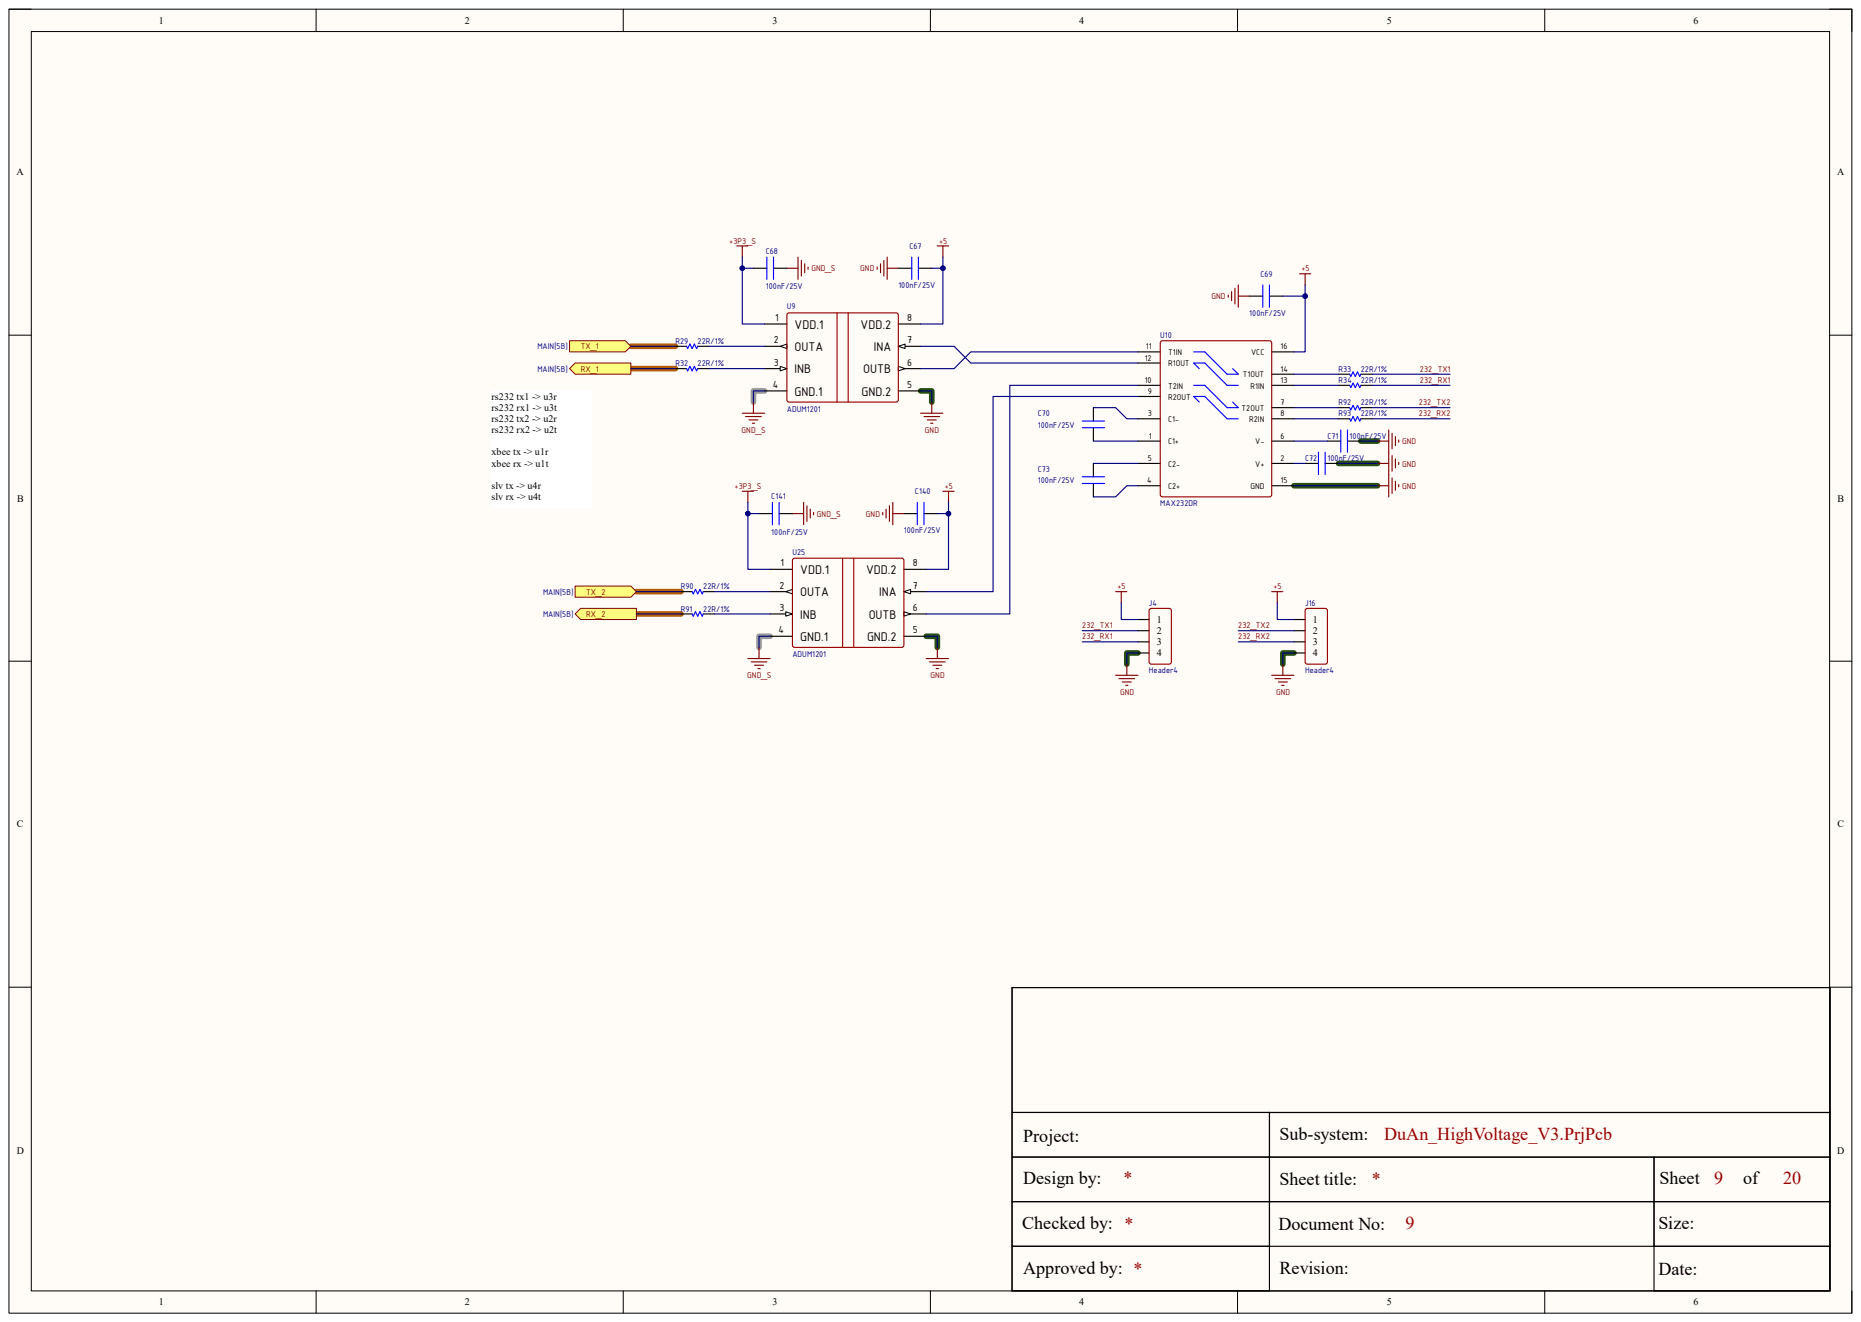
[picture p12: page 9]

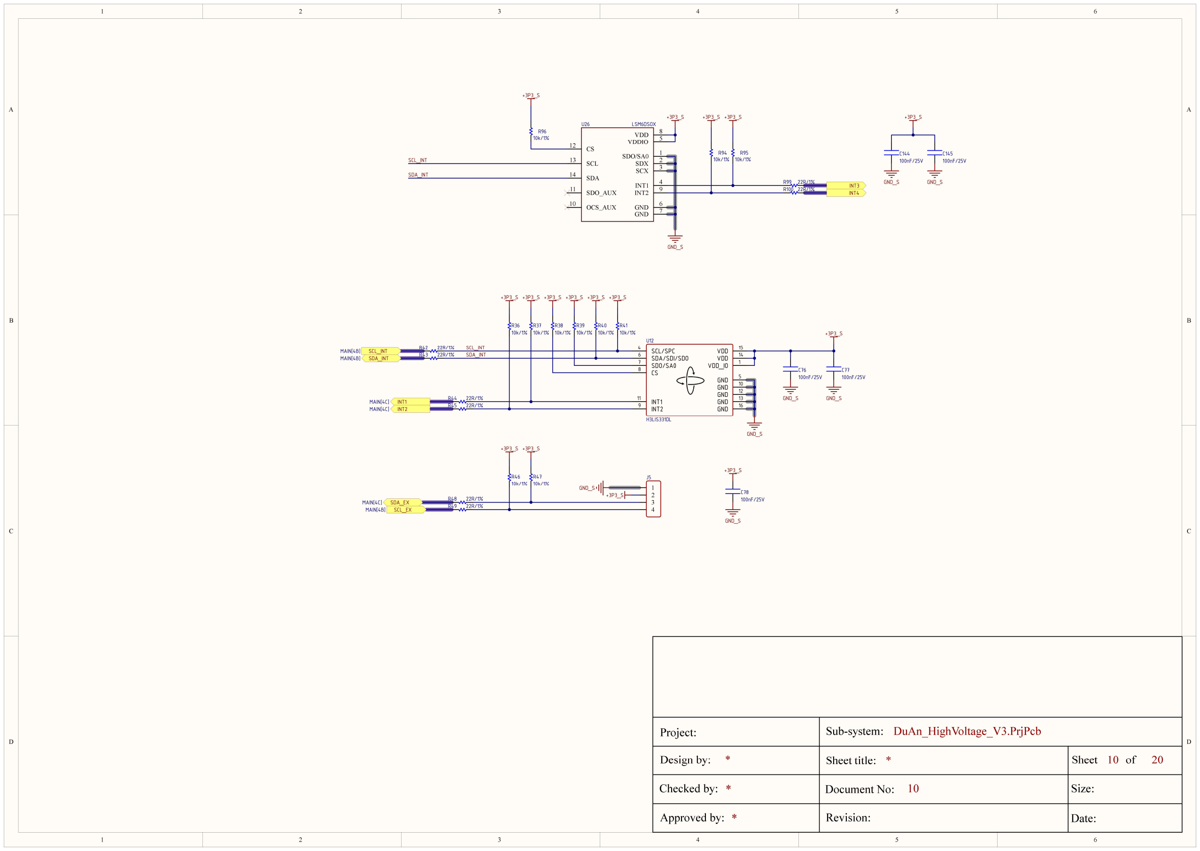
[picture p13: page 10]

D D

C C

B B

A A

# Project:

# Design by:

# Sub-system:

# Sheet title:

# Sheet of

*

# DuAn_HighVoltage_V3.PrjPcb

*

10

10 20

C76
100nF/25V

GND_S

C77
100nF/25V

GND_S

+3P3_S

GND_S

R38
10k/1%

R39
10k/1%

R40
10k/1%

R41
10k/1%

+3P3_S +3P3_S +3P3_S +3P3_S

R36
10k/1%

R37
10k/1%

+3P3_S +3P3_S

MAIN[4B] SCL_INT
MAIN[4B] SDA_INT

MAIN[4C] INT1
MAIN[4C] INT2

1
2
3
4
R46 | J5
10k/1%

R47
10k/1%

+3P3_S +3P3_S

MAIN[4B] SCL_EX

MAIN[4C] SDA_EX

C78
100nF/25V

GND_S
+3P3_S
R42 | 22R/1%
R43 | 22R/1%
R44 | 22R/1%
R45 | 22R/1%
R48 | 22R/1%
R49 | 22R/1%
VDD_IO | 1

### SCL/SPC ⁴

### GND 5

### SDA/SDI/SDO ⁶ SDO/SA0 ⁷ CS ⁸

### INT2 ⁹

| GND | 10
INT1 ¹¹ | GND | 12
| GND | 13

### VDD 14 VDD 15

### GND 16

U12

H3LIS331DL

GND_S

+3P3_S

C144
100nF/25V

GND_S

C145
100nF/25V

GND_S

+3P3_S | +3P3_S

+3P3_S

INT4

INT3 R100 22R/1%

R99 22R/1%

R96
10k/1%

GND_S

CS 12

SDA 14

SDO_AUX 11

OCS_AUX 10

VDD | 8
VDDIO | 5
SDO/SA0 | 1
SDX | 2
SCX | 3
INT1 | 4
INT2 | 9
GND | 6
GND | 7

SCL 13

U26 | LSM6DSOX

SCL_INT
SDA_INT

SCL_INT

SDA_INT

R94
10k/1%

+3P3_S

R95
10k/1%

+3P3_S

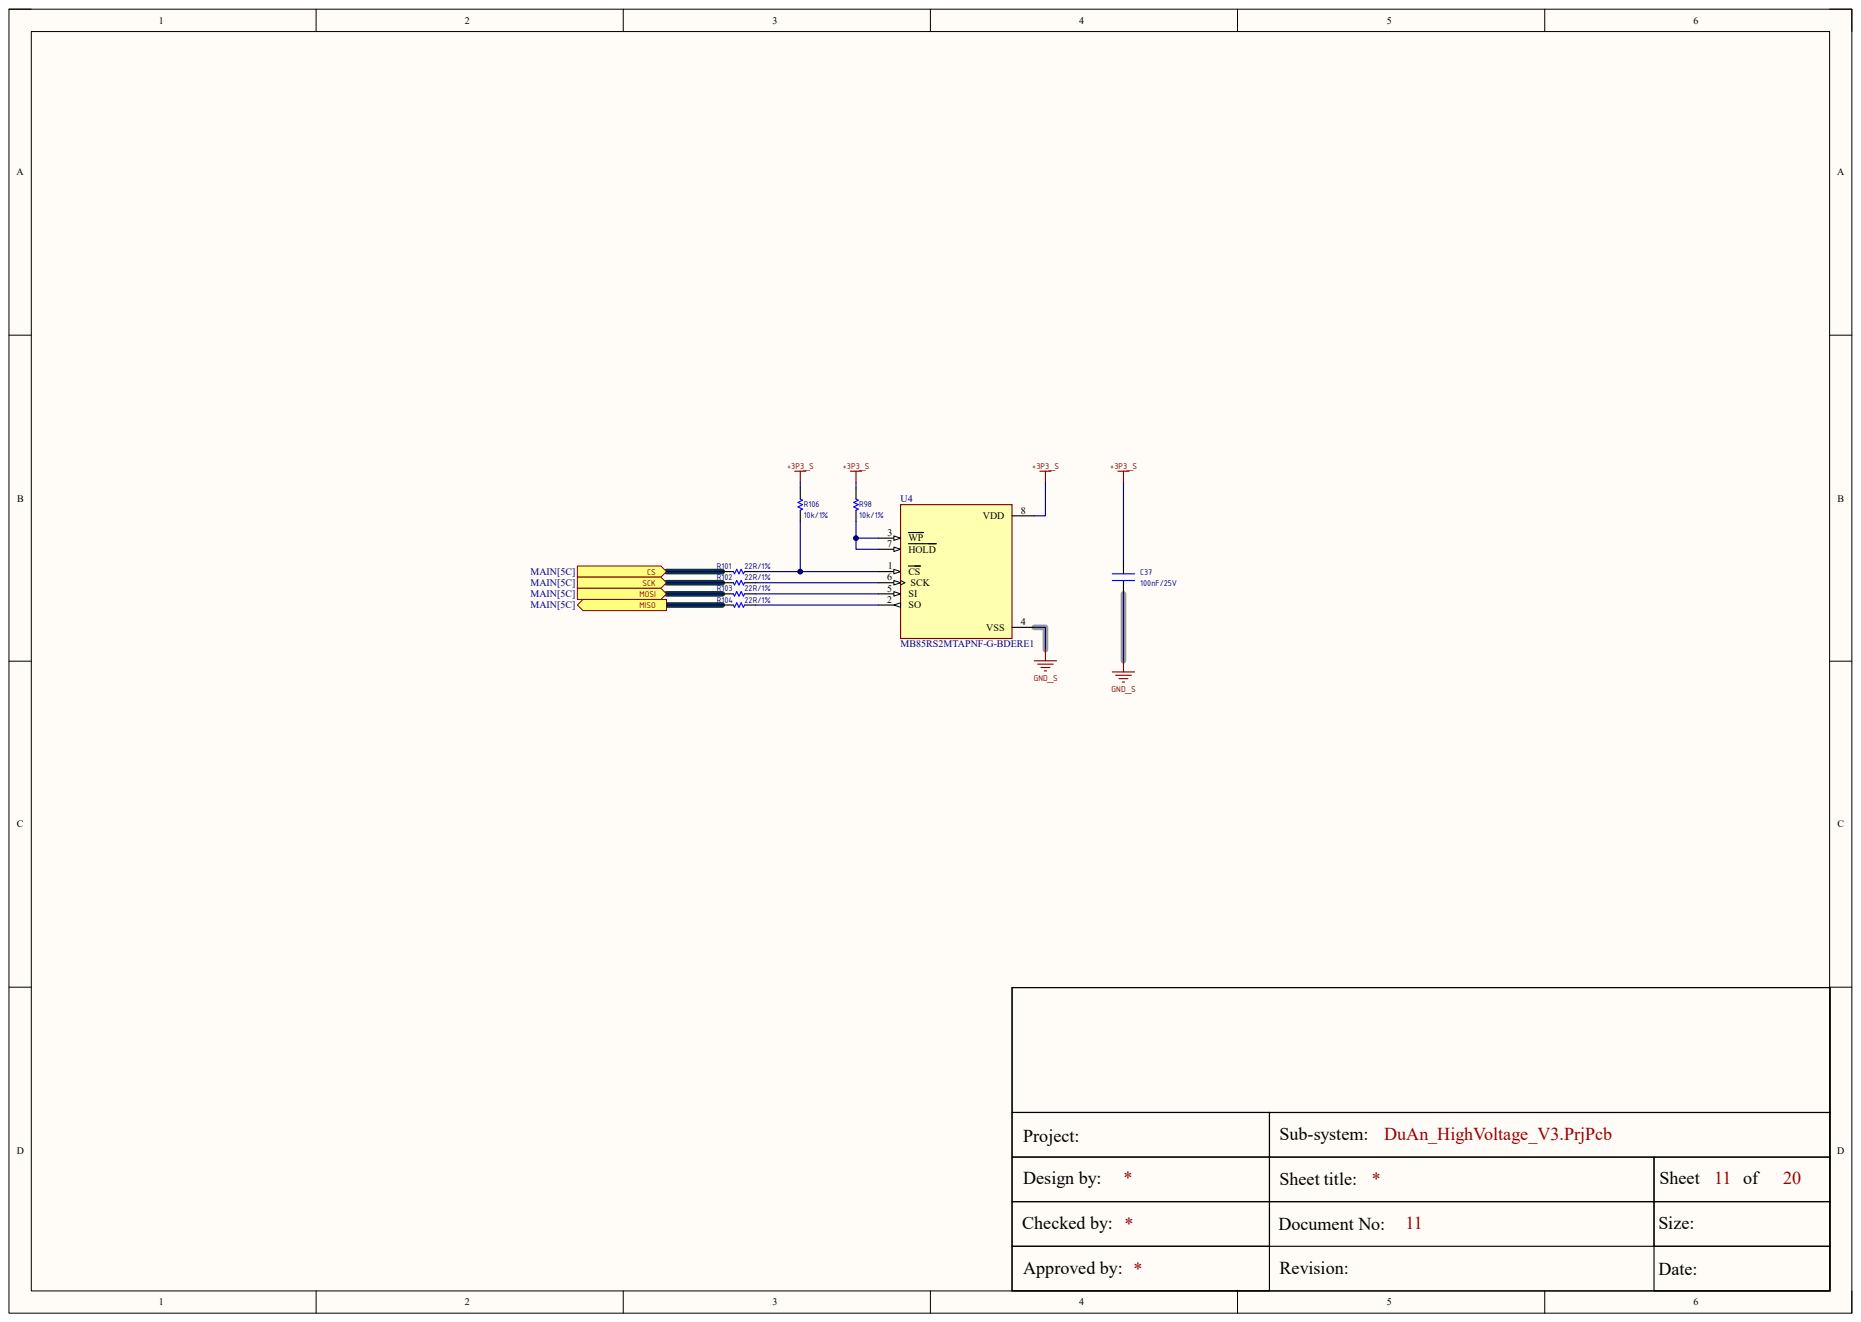
[picture p14: page 11]

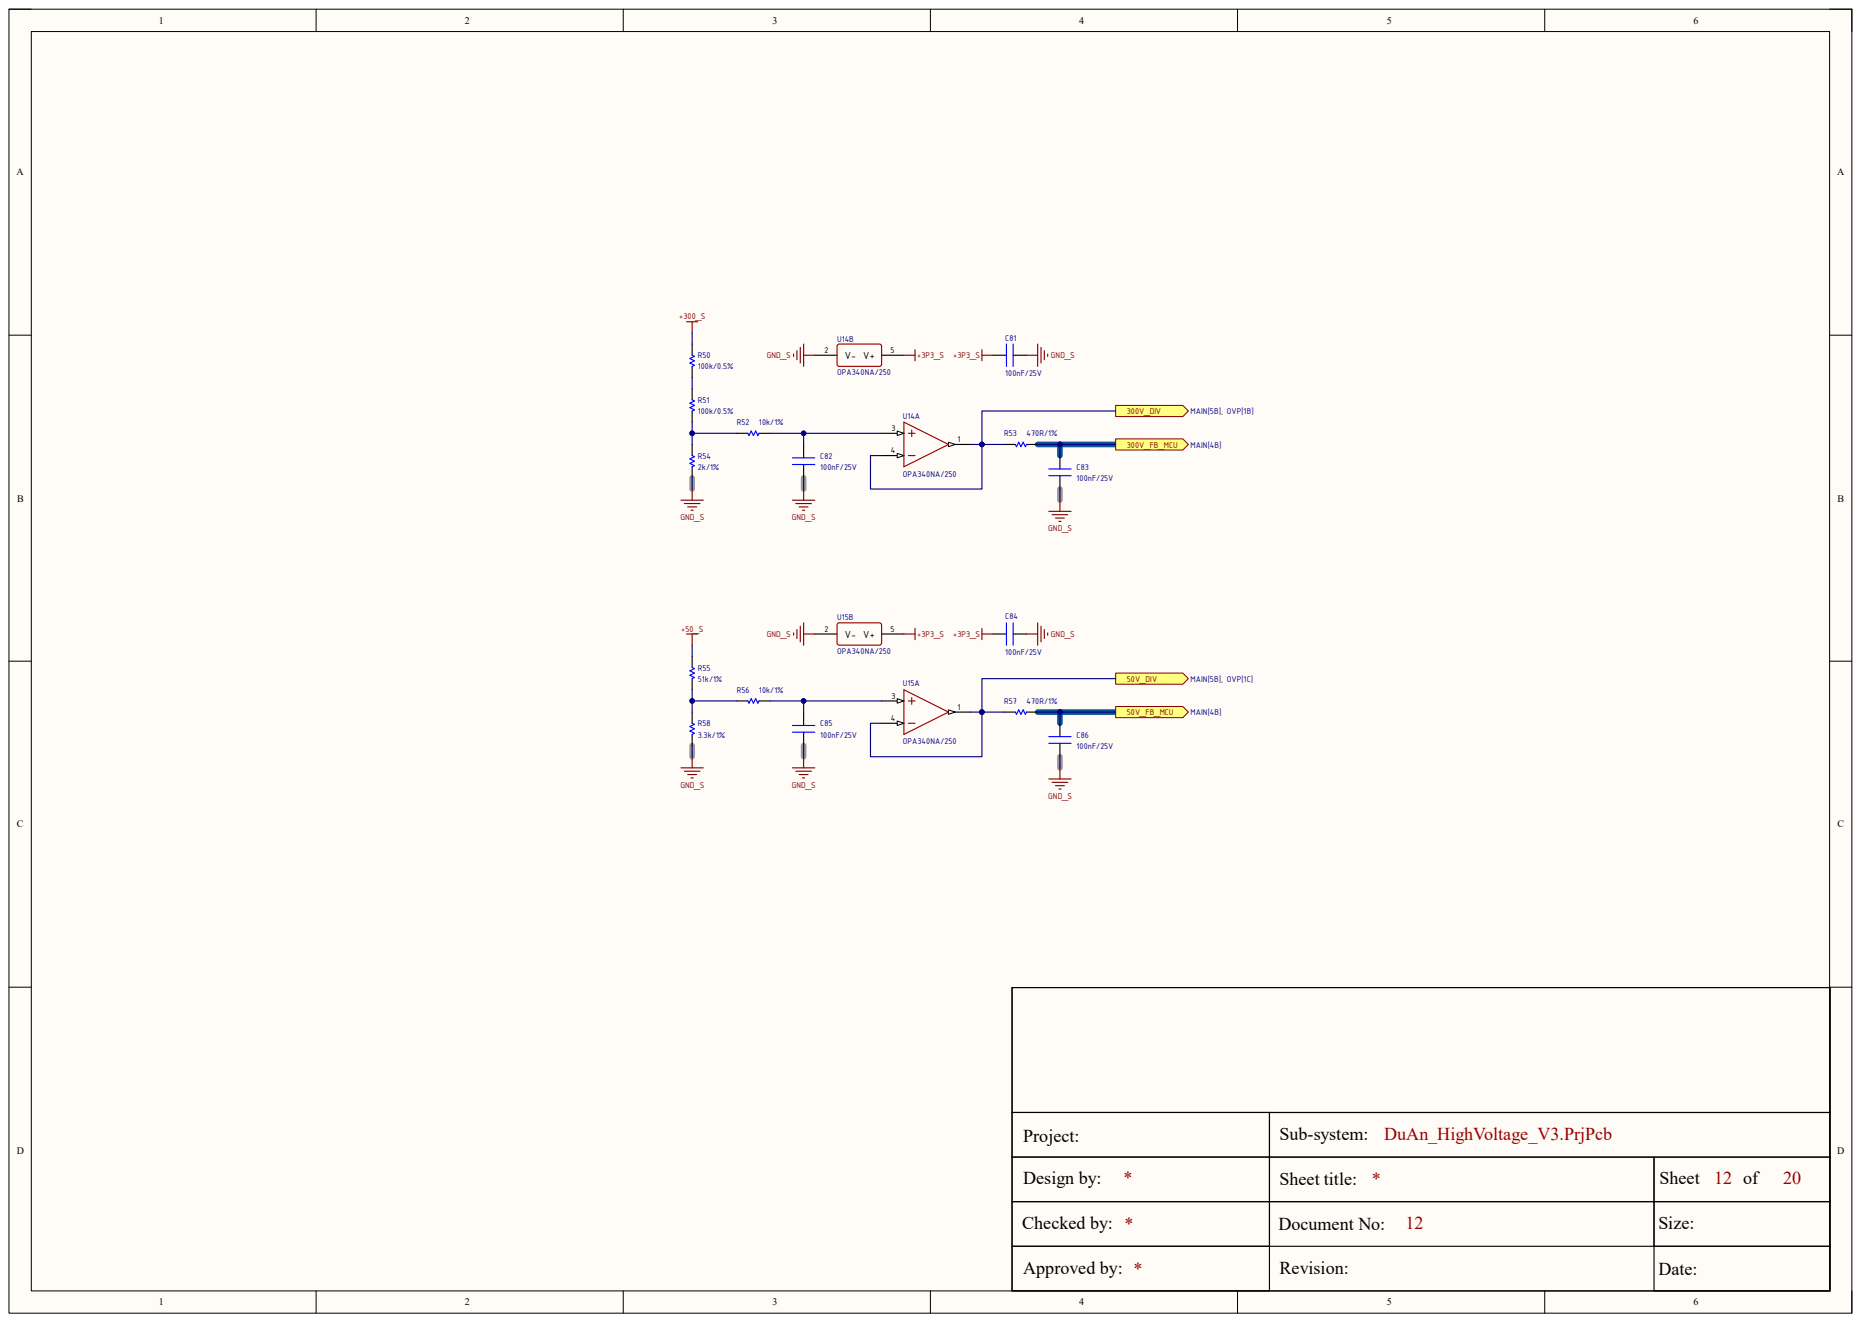
[picture p15: page 12]

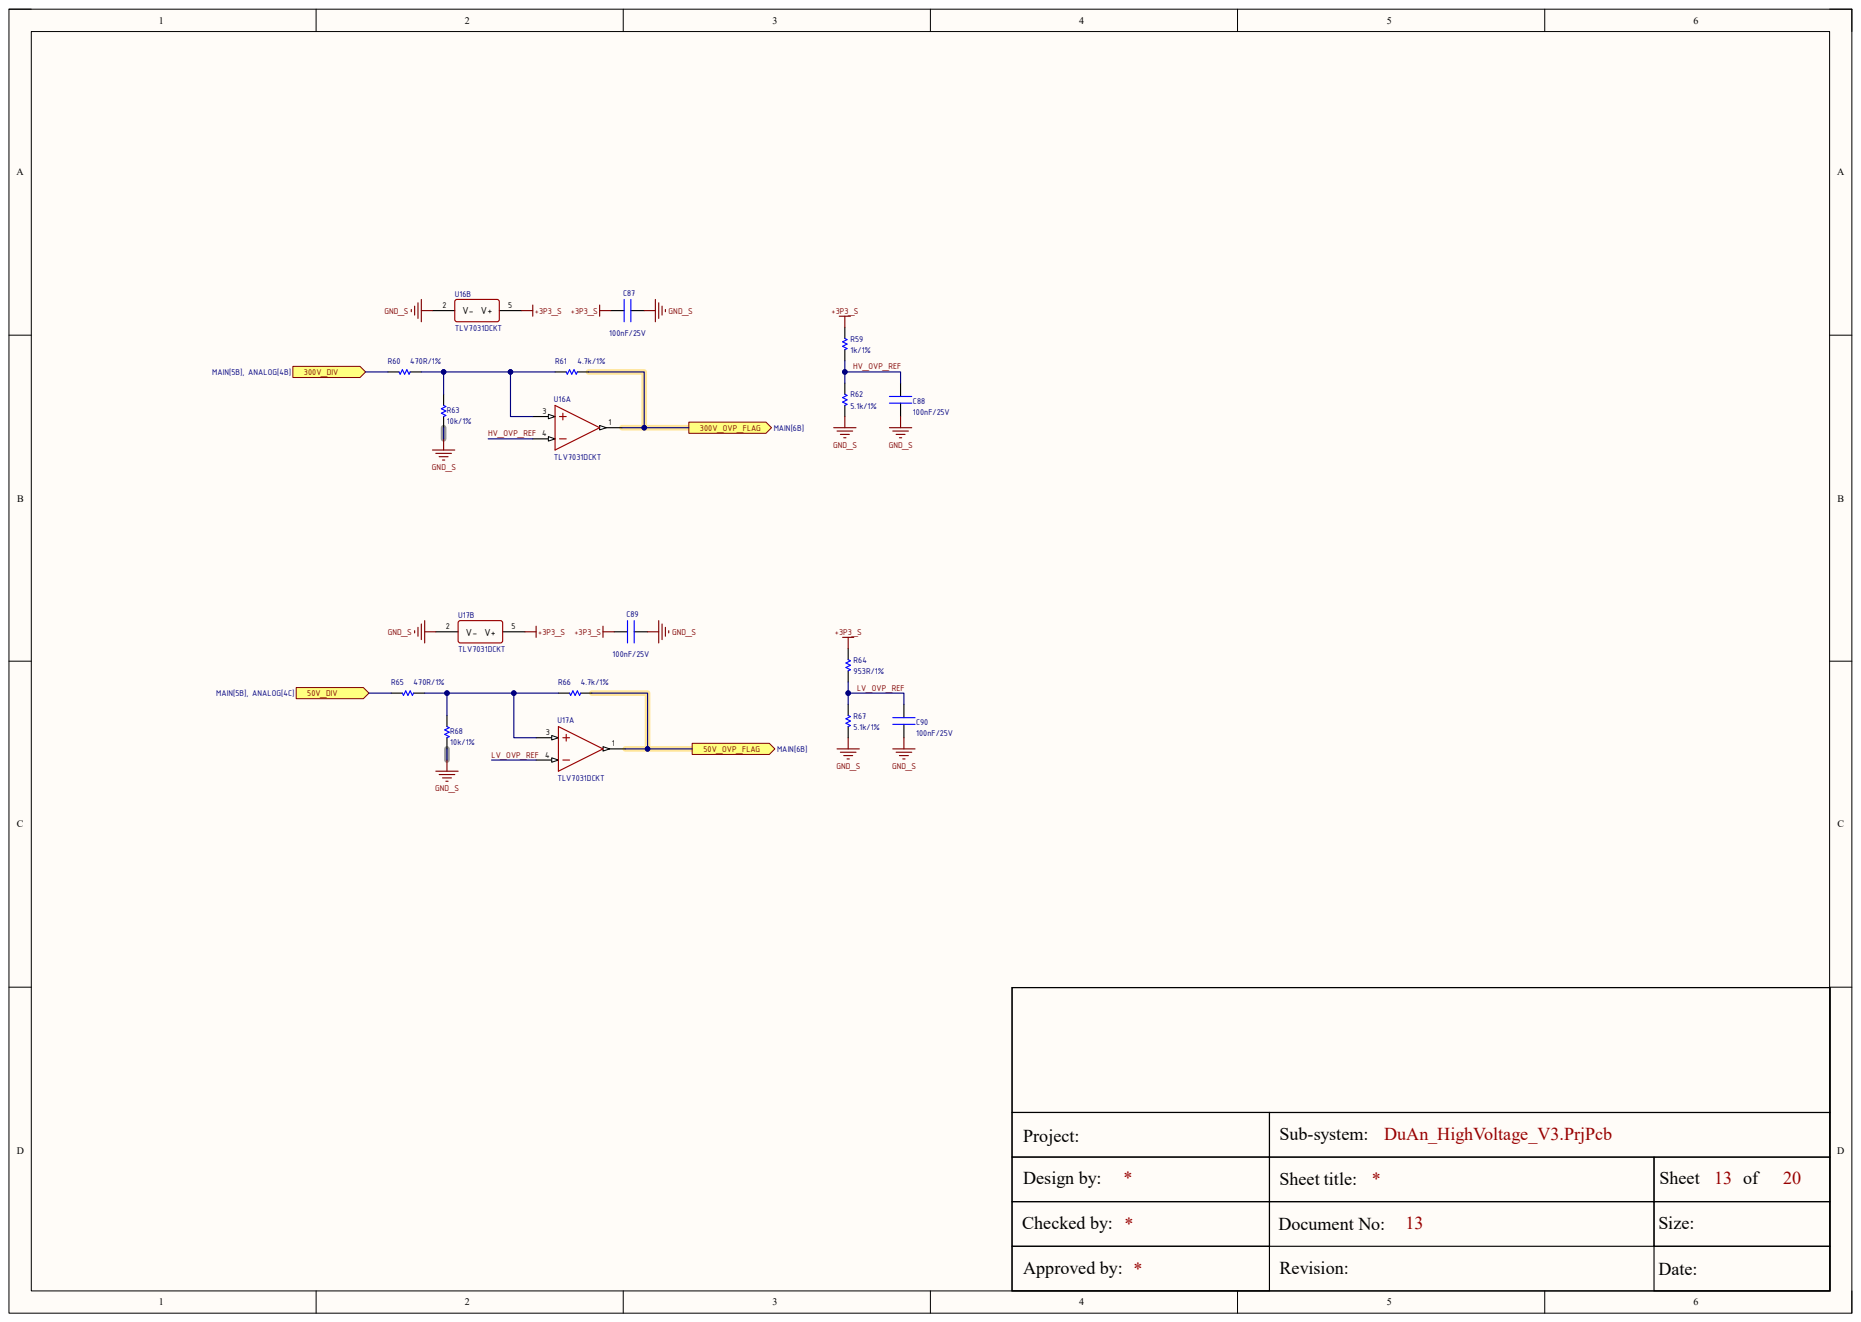
[picture p16: page 13]

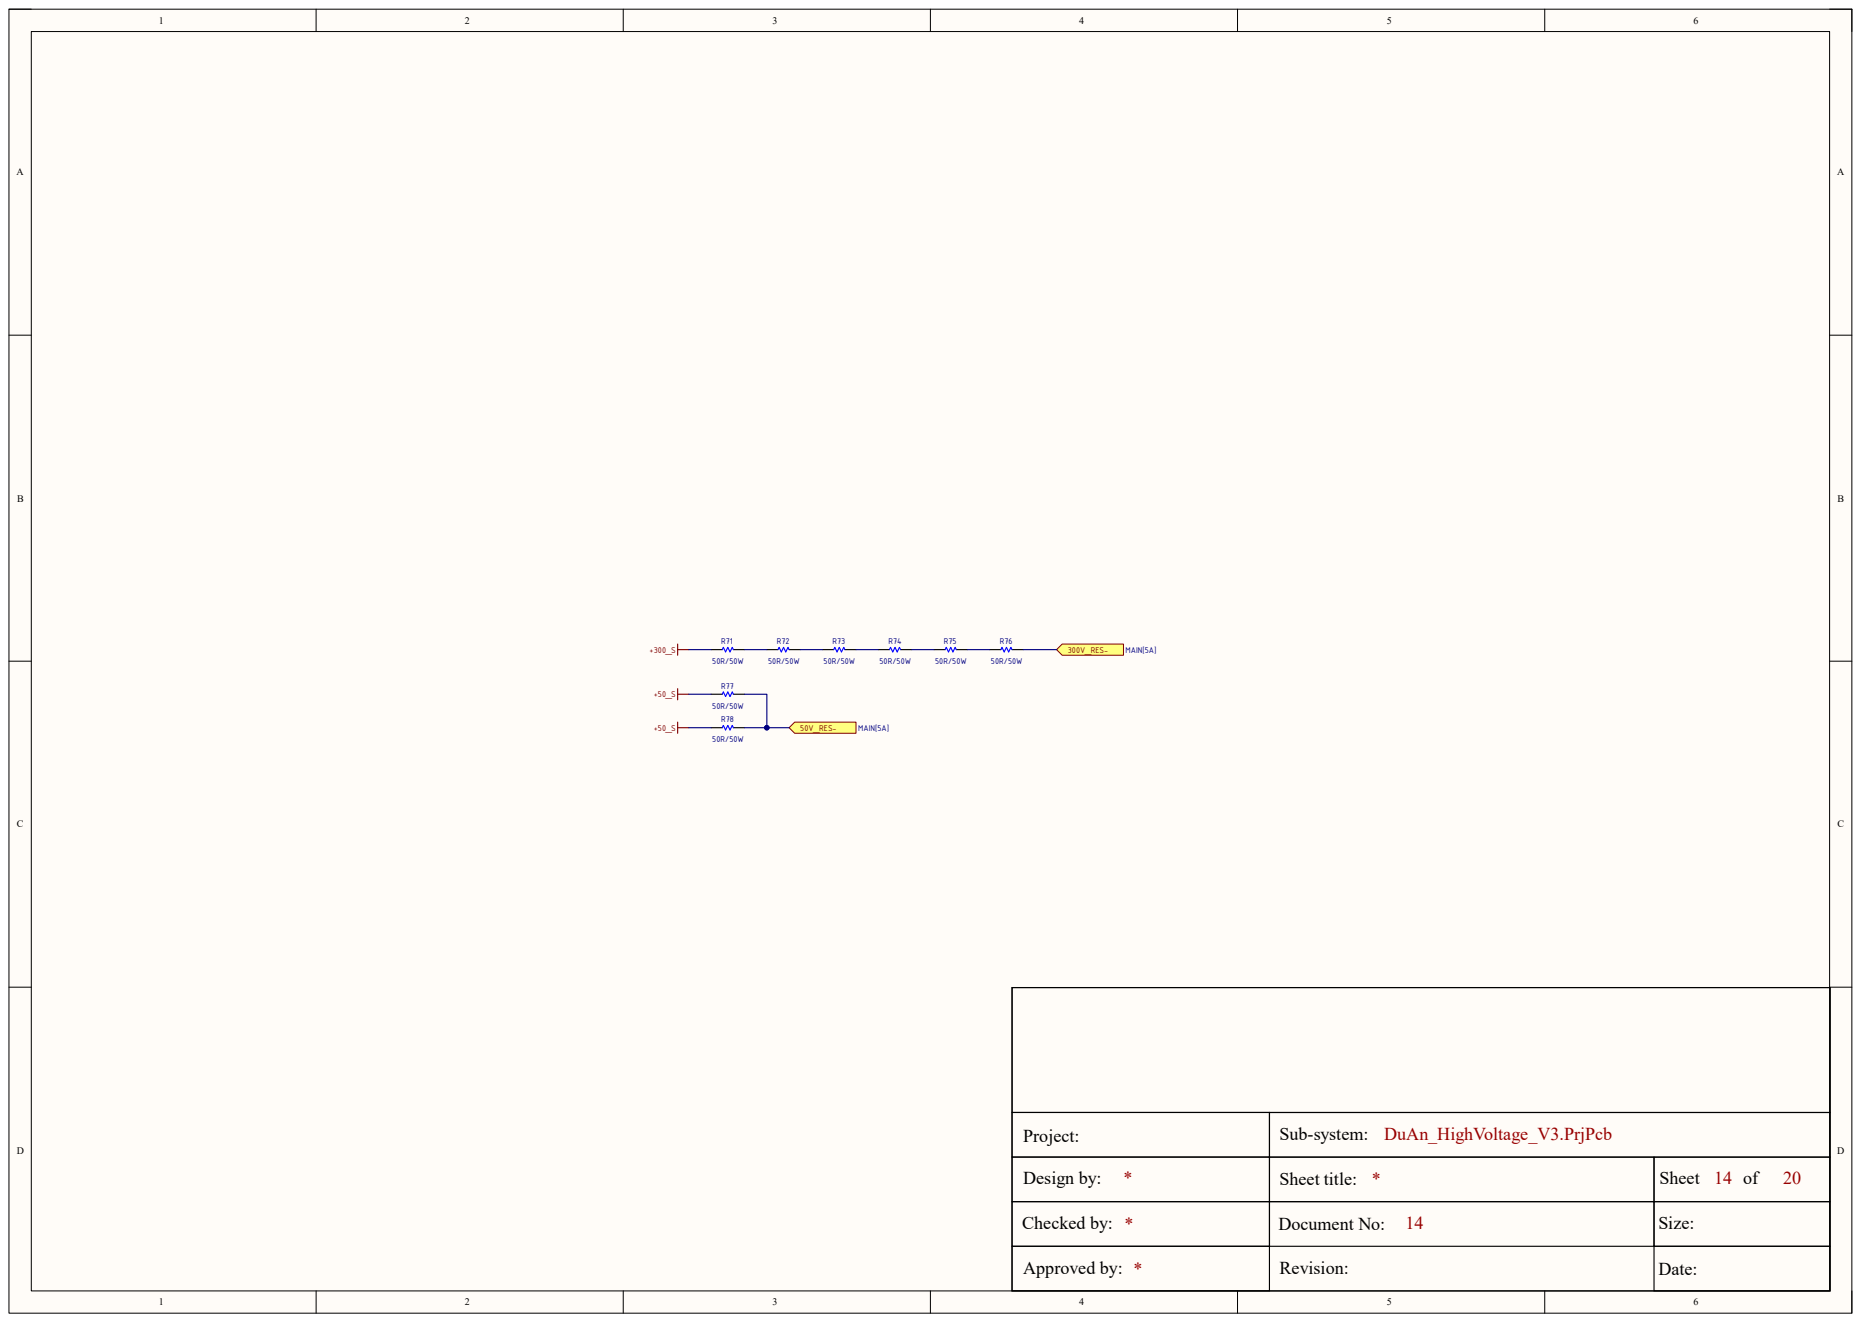
[picture p17: page 14]

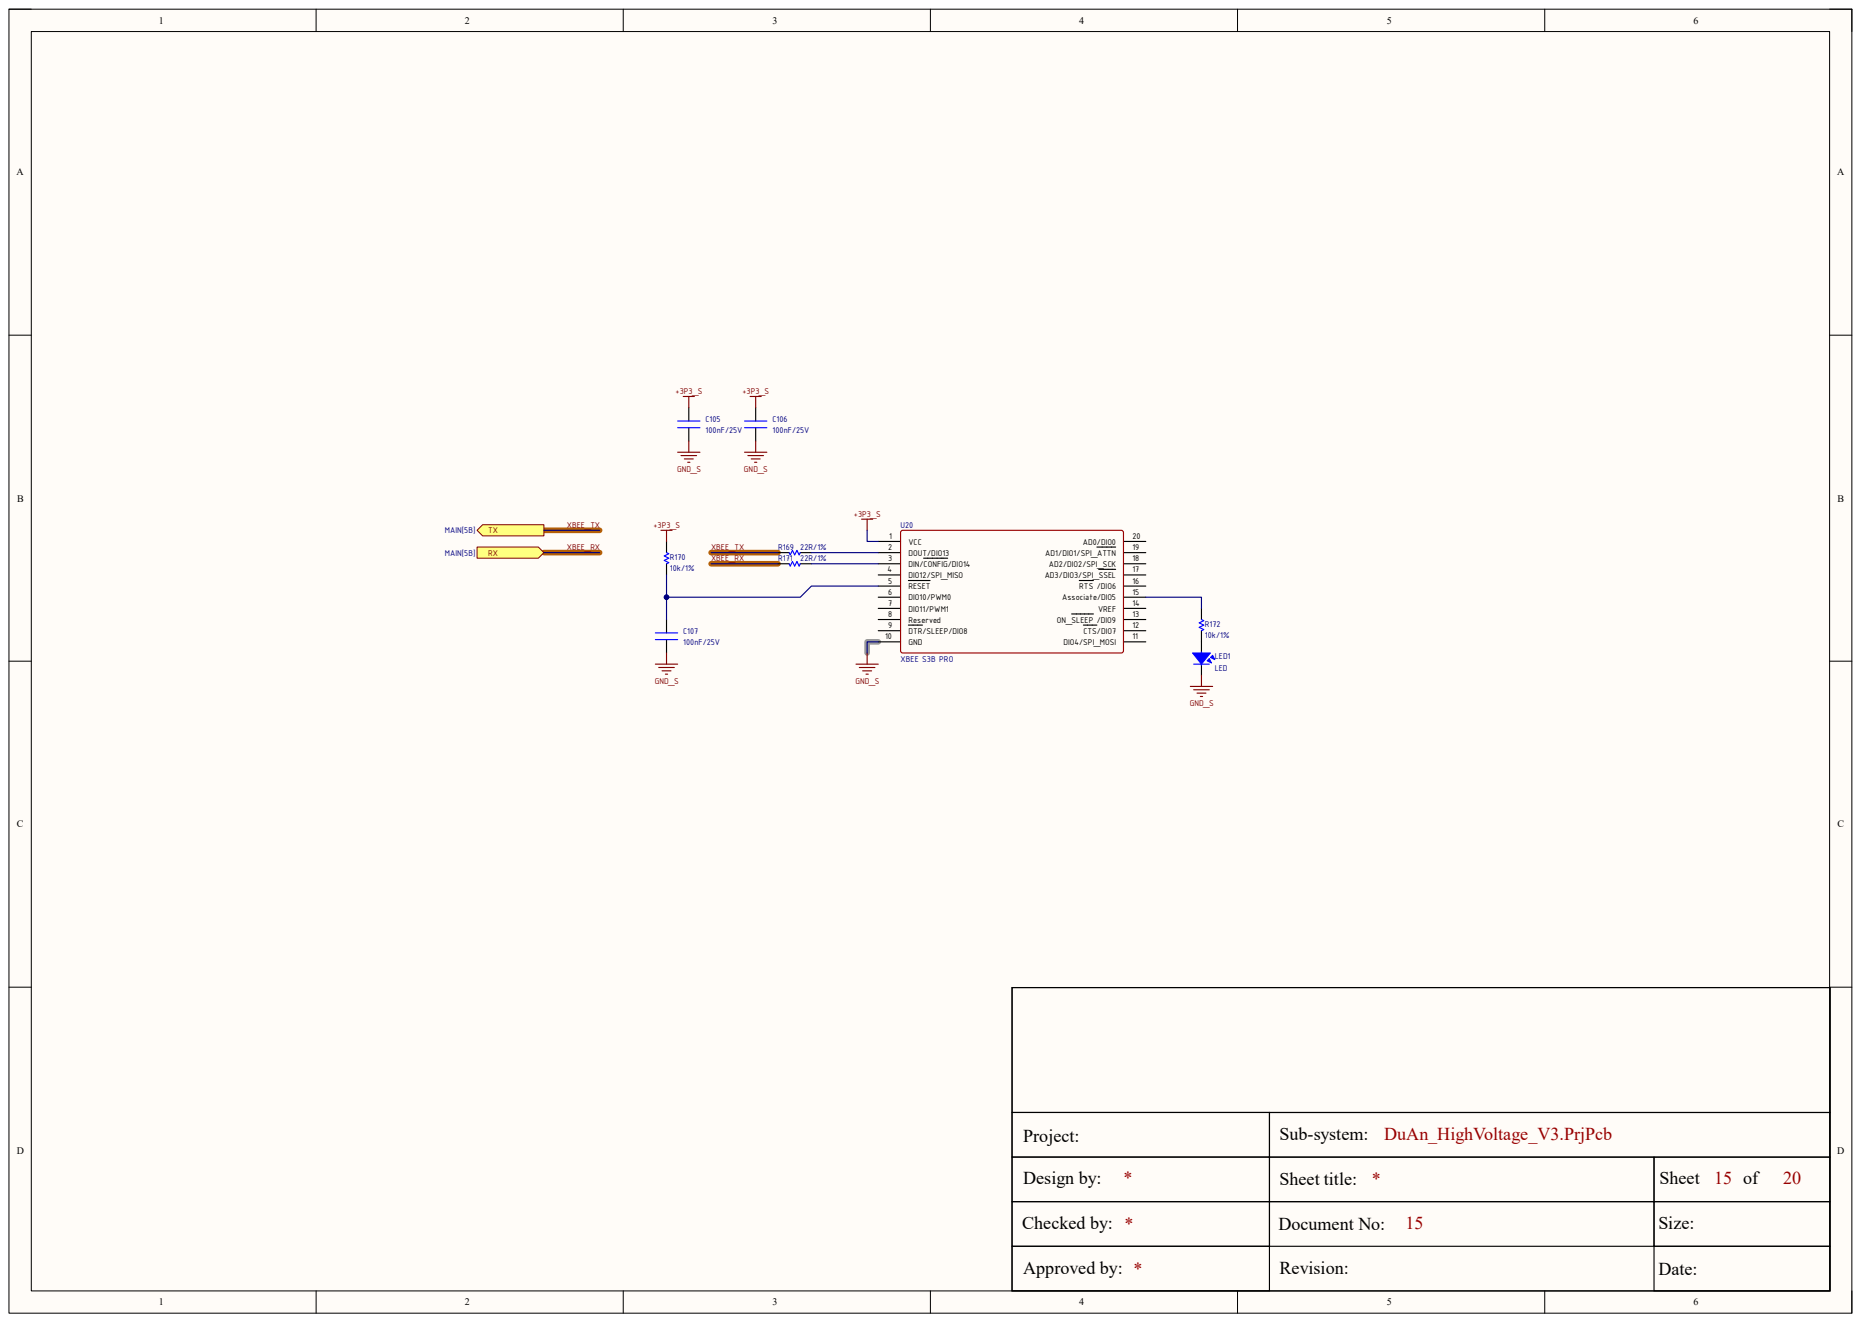
[picture p18: page 15]

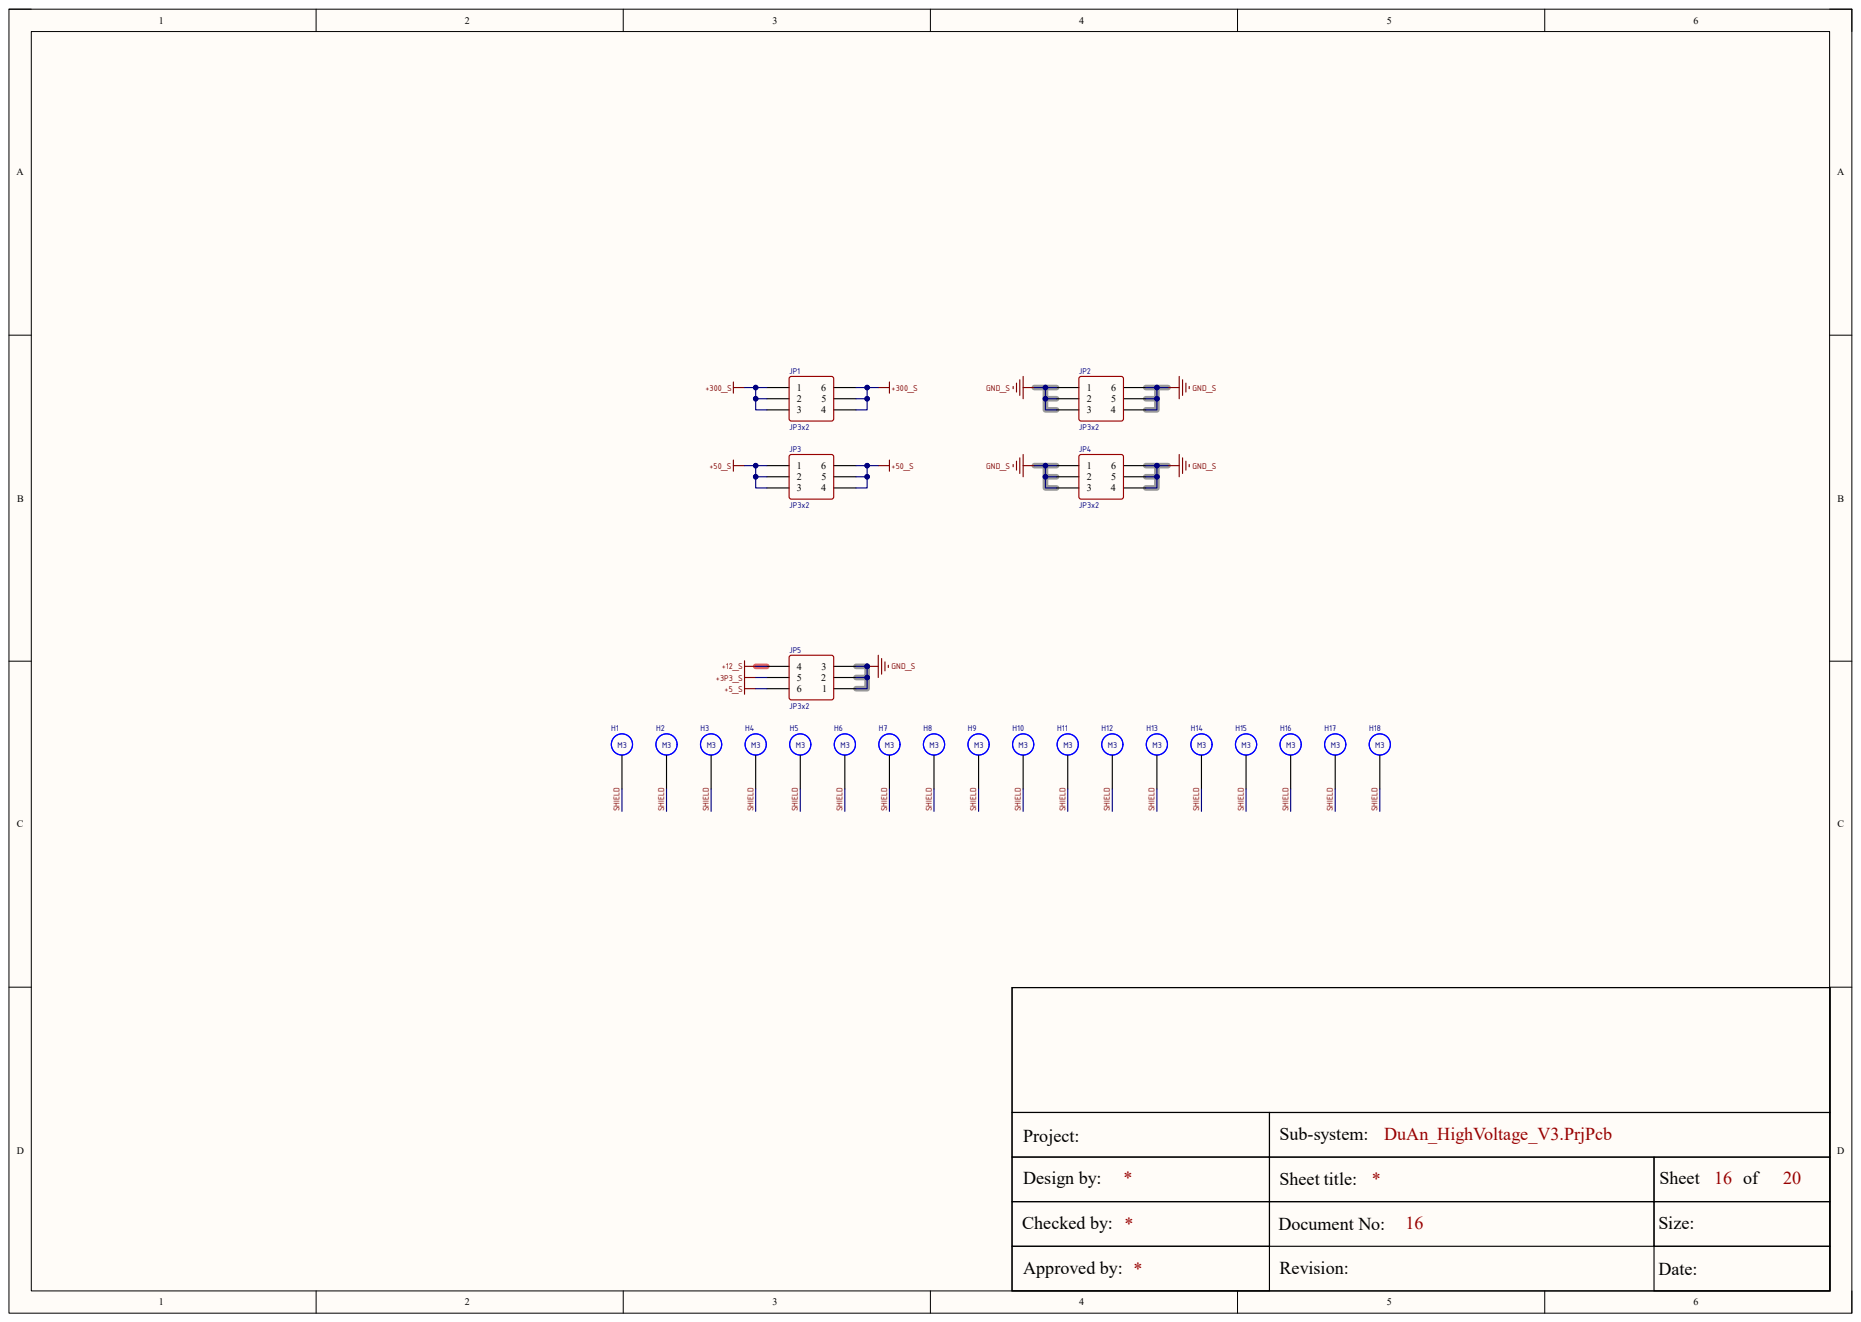
[picture p19: page 16]
Project:; Design by:; Sub-system:; Sheet title:; Sheet; DuAn_HighVoltage_V3.PrjPcb; GND_S; H1 M3SHIELD; H2 M3SHIELD; H3 M3SHIELD; H4 M3SHIELD; H5 M3SHIELD; H6 M3SHIELD; H7 M3SHIELD; H8 M3SHIELD; H9 M3SHIELD; H10 M3SHIELD; H11 M3SHIELD; H12 M3SHIELD; H13 M3SHIELD; H14 M3SHIELD; H15 M3SHIELD; H16 M3SHIELD; H17 M3SHIELD; H18 M3SHIELD

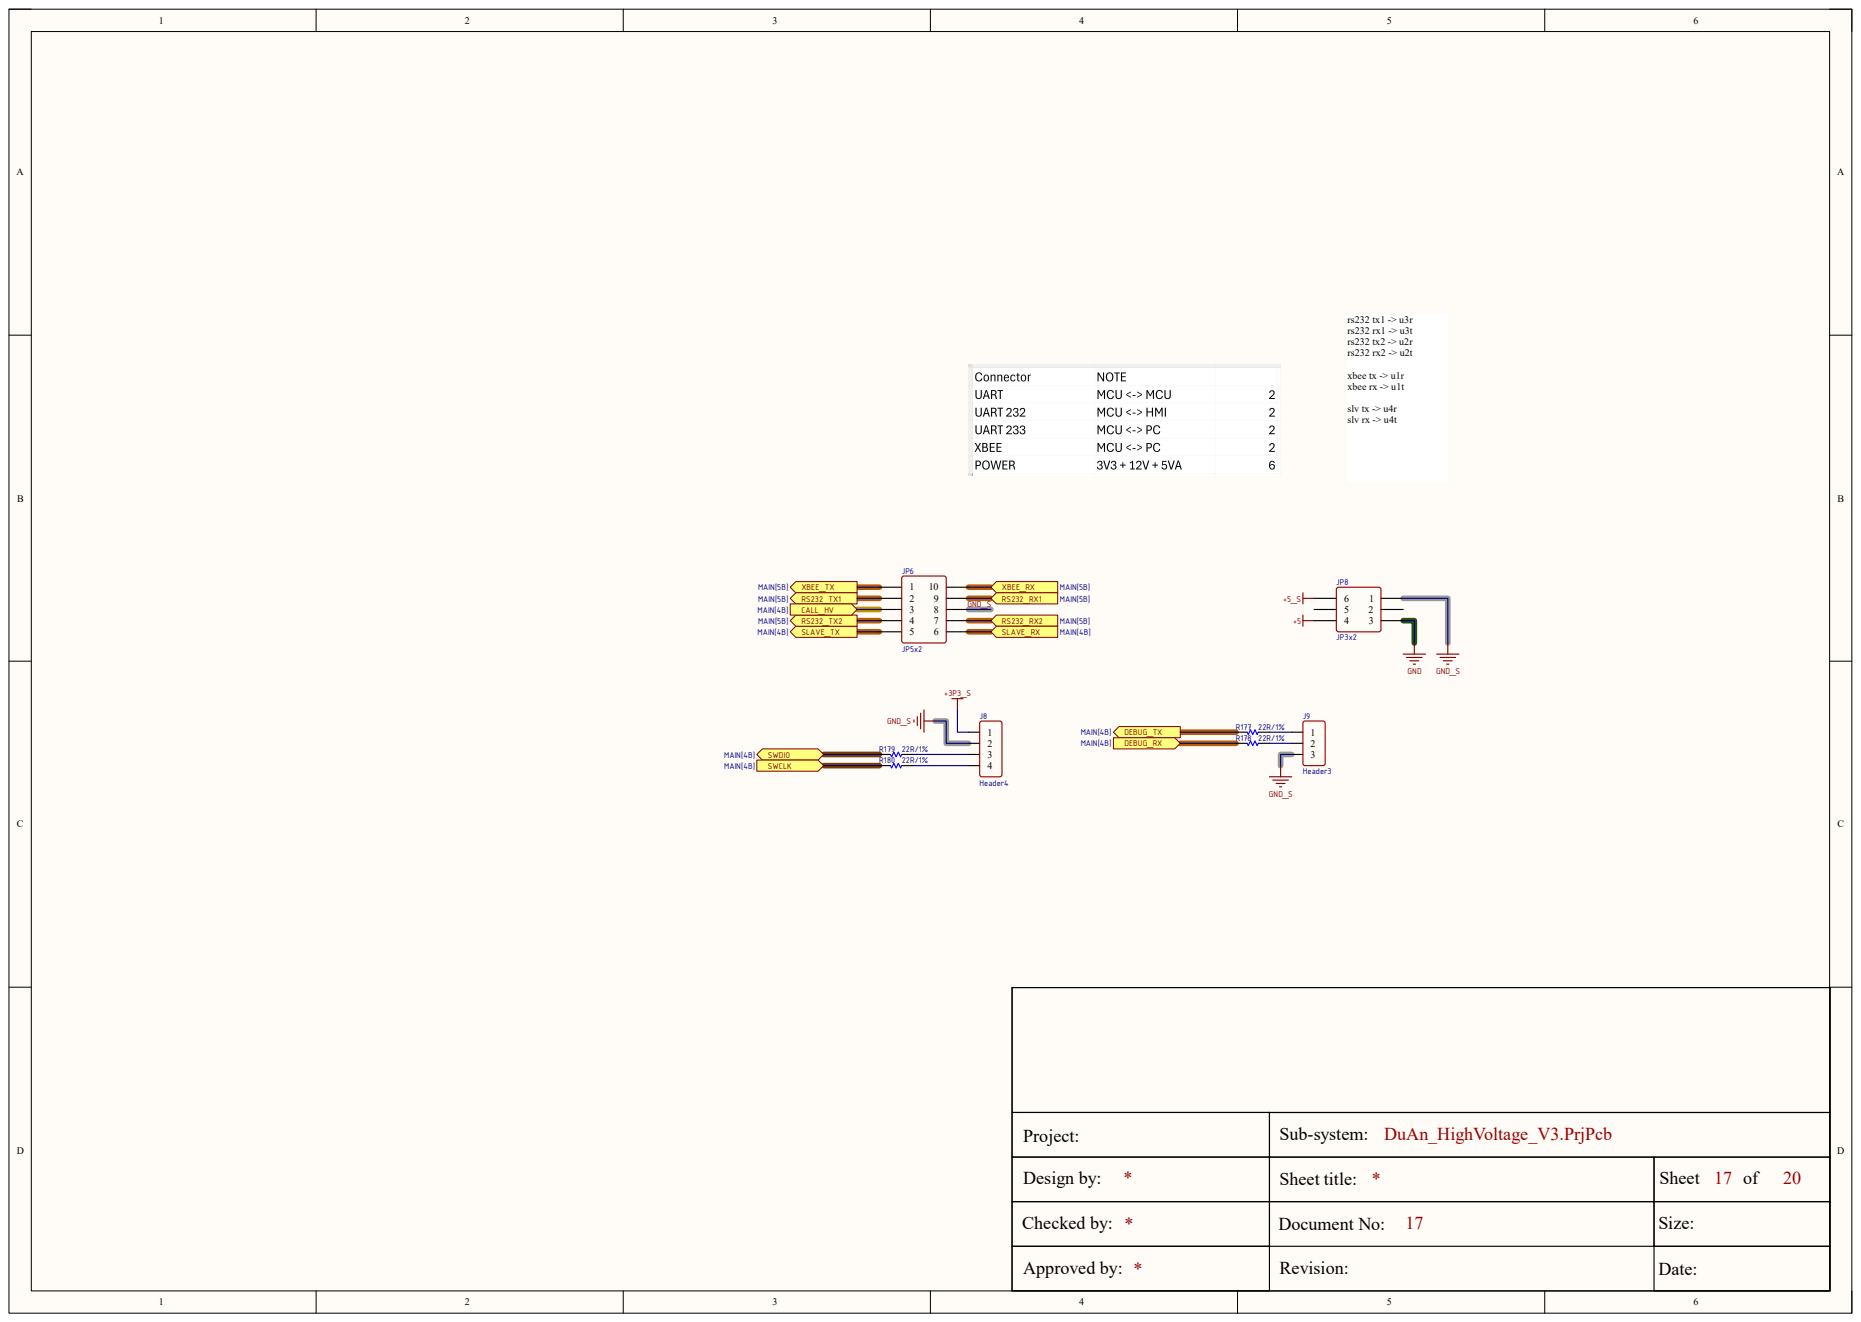
[picture p20: page 17]

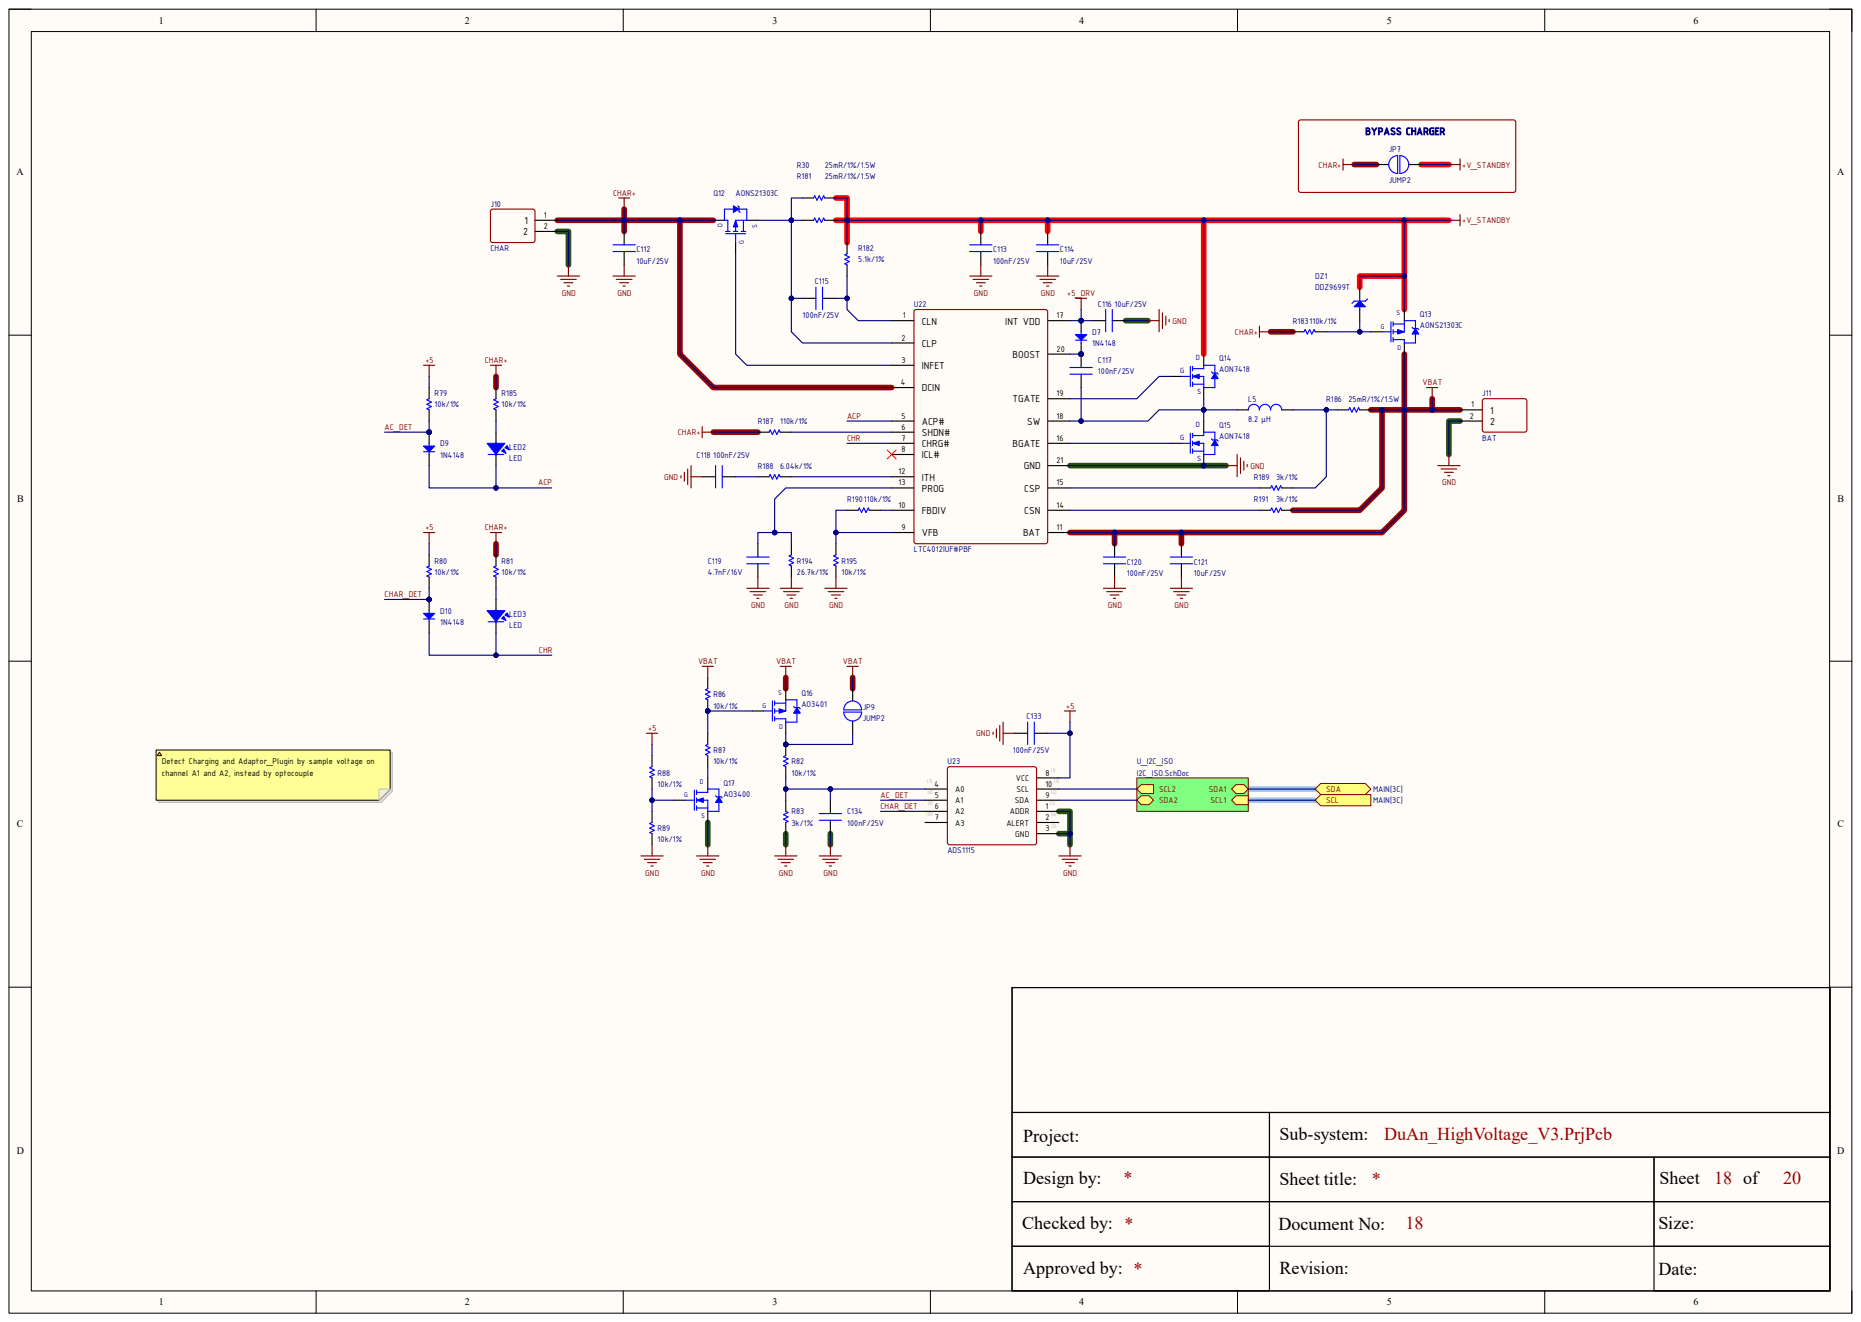
[picture p21: page 18]

Detect Charging and Adaptor_Plugin by sample voltage on
channel A1 and A2, instead by optocouple

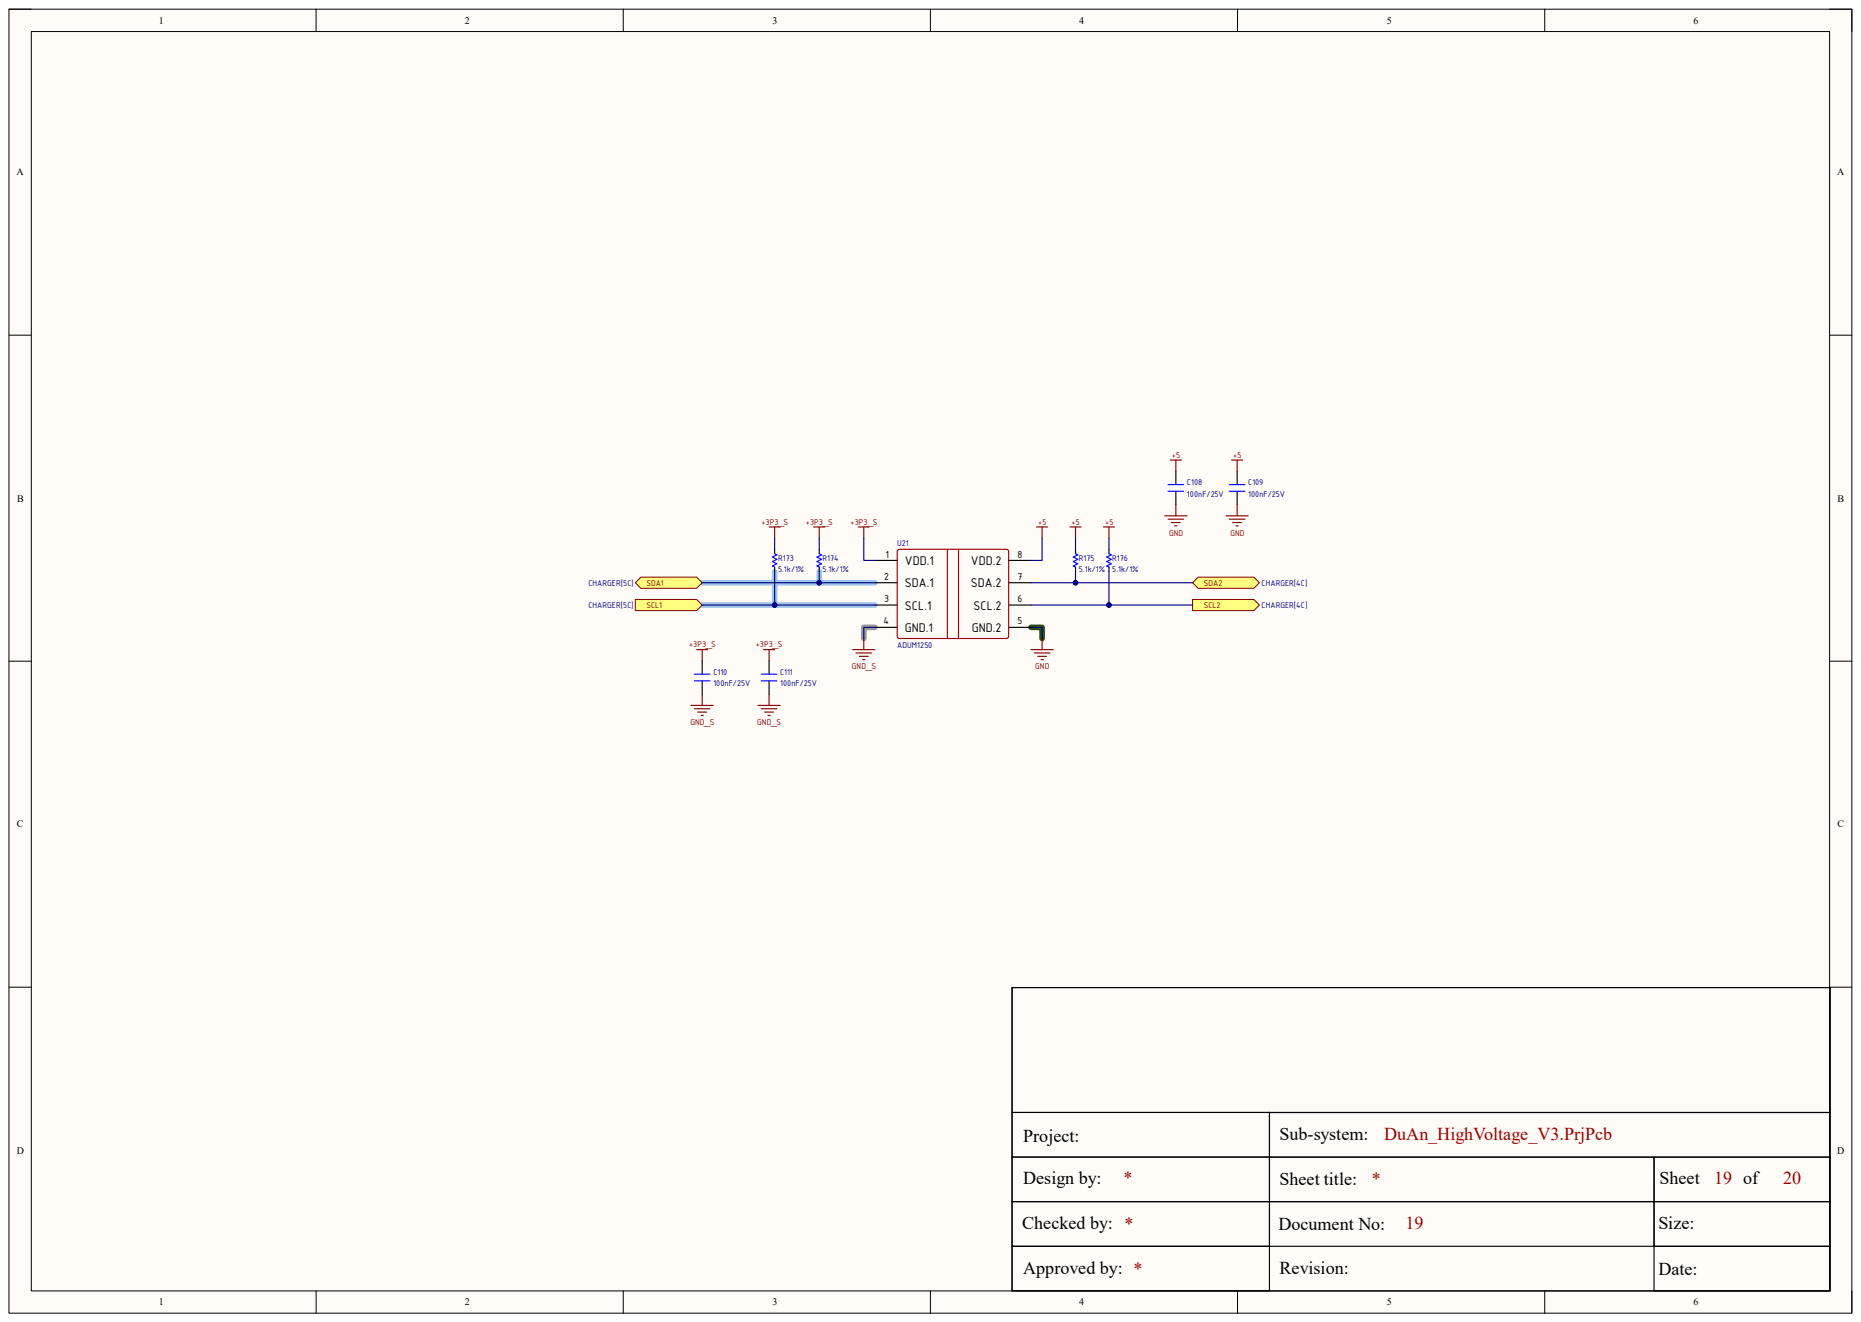
[picture p22: page 19]

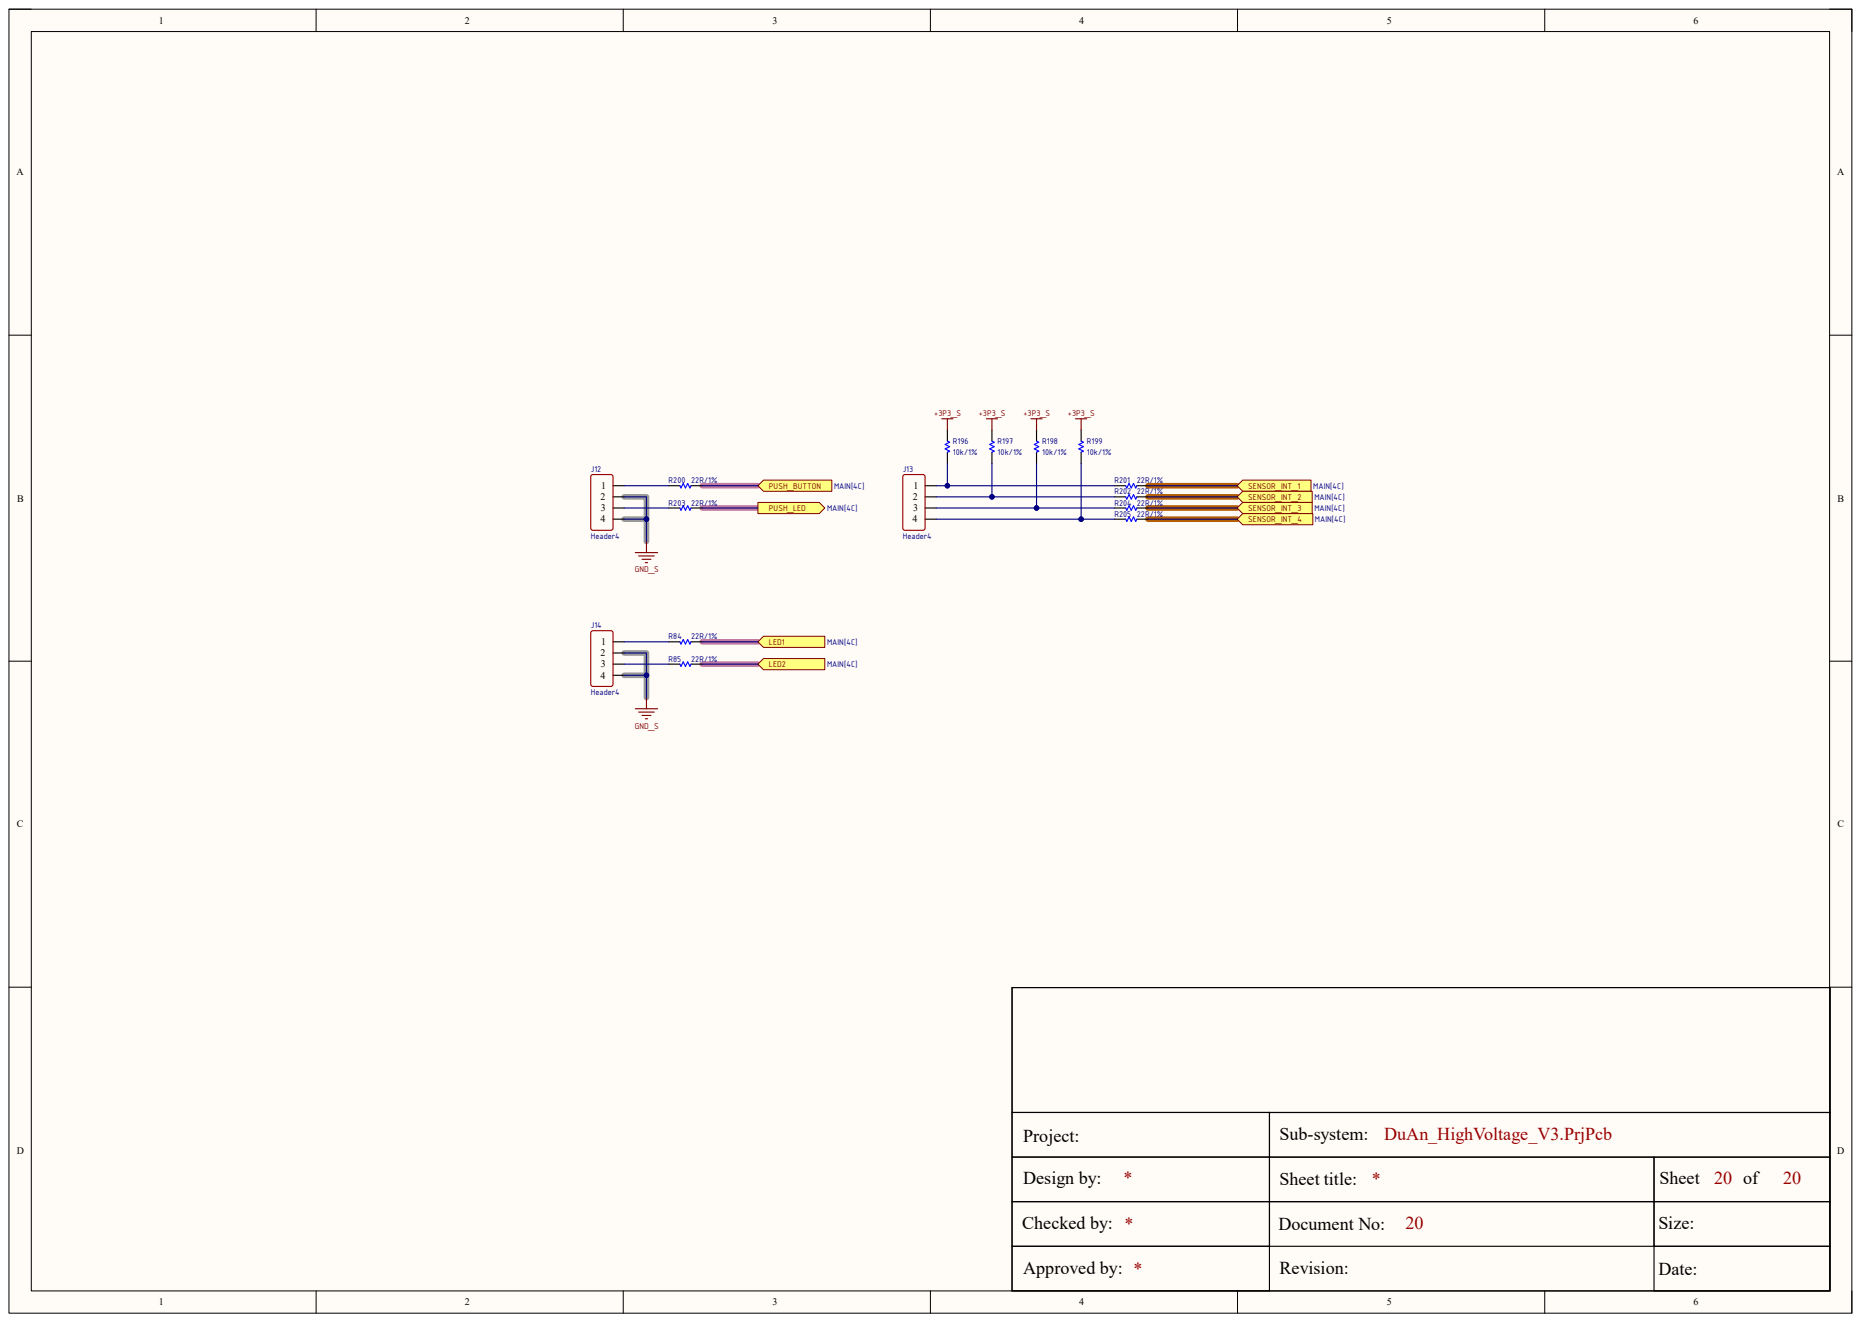
[picture p23: page 20]
