baobuibk/SpaceLiinTech_HighVoltage_Electroporator_HW_V3.0.0_Controller/(list of files, drawings)

Other design files:
01_DESIGN/ACCELEROMETER.SchDoc
01_DESIGN/ANALOG.SchDoc
01_DESIGN/BATTERY_CHARGER.SchDoc
01_DESIGN/CAP_RELEASE.SchDoc
01_DESIGN/CAPACITOR.SchDoc
01_DESIGN/CHARGER.SchDoc
01_DESIGN/COMUNICATE_CON.SchDoc
01_DESIGN/DuAn_HighVoltage_V3.PrjPcb
01_DESIGN/EEPROM.SchDoc
01_DESIGN/EXTERNAL_FAN.SchDoc
01_DESIGN/FLYBACK.SchDoc
01_DESIGN/I2C_ISO.SchDoc
01_DESIGN/INPUT_PROTECTION.SchDoc
01_DESIGN/MAIN.SchDoc
01_DESIGN/OVP.SchDoc
01_DESIGN/PERIPHERAL_CON.SchDoc
01_DESIGN/POWER_CON.SchDoc
01_DESIGN/PRIMARY_POWER.SchDoc
01_DESIGN/RS232.SchDoc
01_DESIGN/SECONDARY_POWER.SchDoc
01_DESIGN/TEMPERATURE_SENSOR.SchDoc
01_DESIGN/XBEE.SchDoc
