baobuibk/SpaceLiinTech_HighVoltage_Electroporator_HW_V3.0.0_Controller/(commit log)

2026-04-08 First commit: Upload High Voltage Controller V3 Hardware
    [ACCELEROMETER.SchDoc, ANALOG.SchDoc, BATTERY_CHARGER.SchDoc, CAPACITOR.SchDoc, CAP_RELEASE.SchDoc, CHARGER.SchDoc, COMUNICATE_CON.SchDoc, DuAn_HighVoltage_PCB_V3.0.xls]
2026-04-12 update and fix 12042026
    [ANALOG.SchDoc, DuAn_HighVoltage_PCB_V3.0.xls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]
2026-04-13 update gerrber 130426
    [DuAn_HighVoltage_PCB_V3.0_Copper_Signal_1.gbr, DuAn_HighVoltage_PCB_V3.0_Copper_Signal_2.gbr, DuAn_HighVoltage_PCB_V3.0_Copper_Signal_Bot.gbr, DuAn_HighVoltage_PCB_V3.0_Copper_Signal_Top.gbr, DuAn_HighVoltage_PCB_V3.0_Drawing_1.gbr, DuAn_HighVoltage_PCB_V3.0_Drillmap_1.gbr, DuAn_HighVoltage_PCB_V3.0_Legend_Bot.gbr, DuAn_HighVoltage_PCB_V3.0_Legend_Top.gbr]
2026-04-13 fix: gerber
    [CHARGER.SchDoc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]
2026-04-17 update BOM 170426
    [DuAn_HighVoltage_V3.2.xlsx]
